waju84/Avarma-R290-Steuerung/docs/bilder/02_verlauf.png

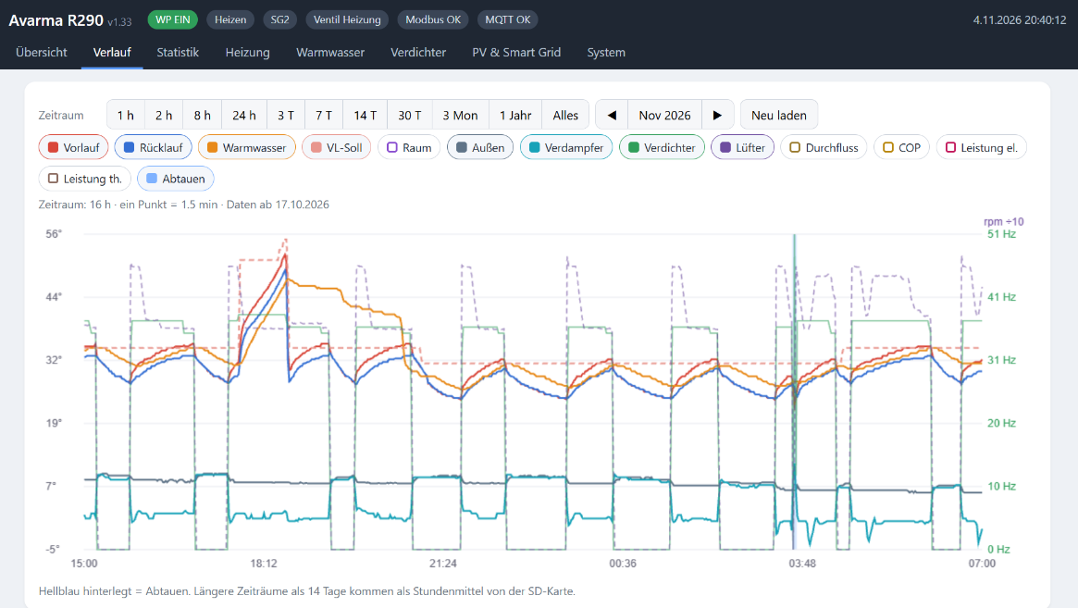
docs/bilder/02_verlauf.png
