waju84/Avarma-R290-Steuerung/docs/bilder/03_statistik.png

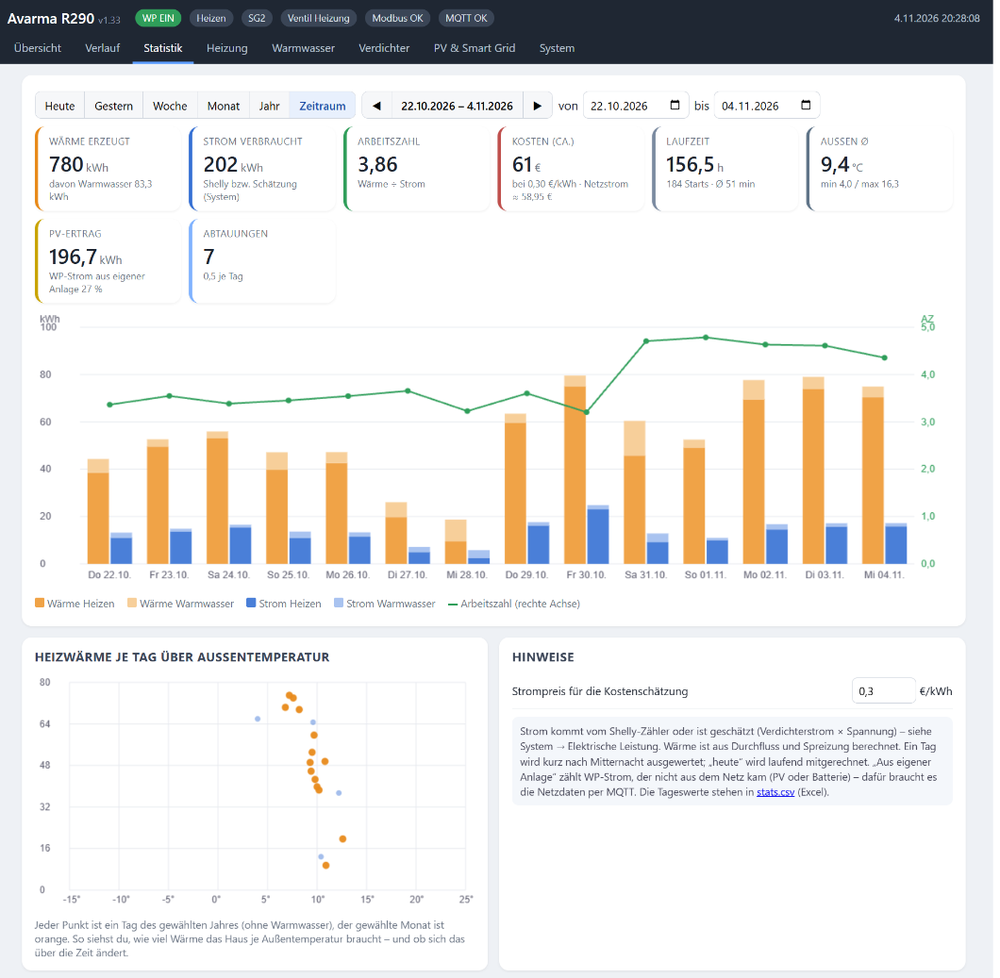
docs/bilder/03_statistik.png
