waju84/Avarma-R290-Steuerung/docs/bilder/04_heizung.png

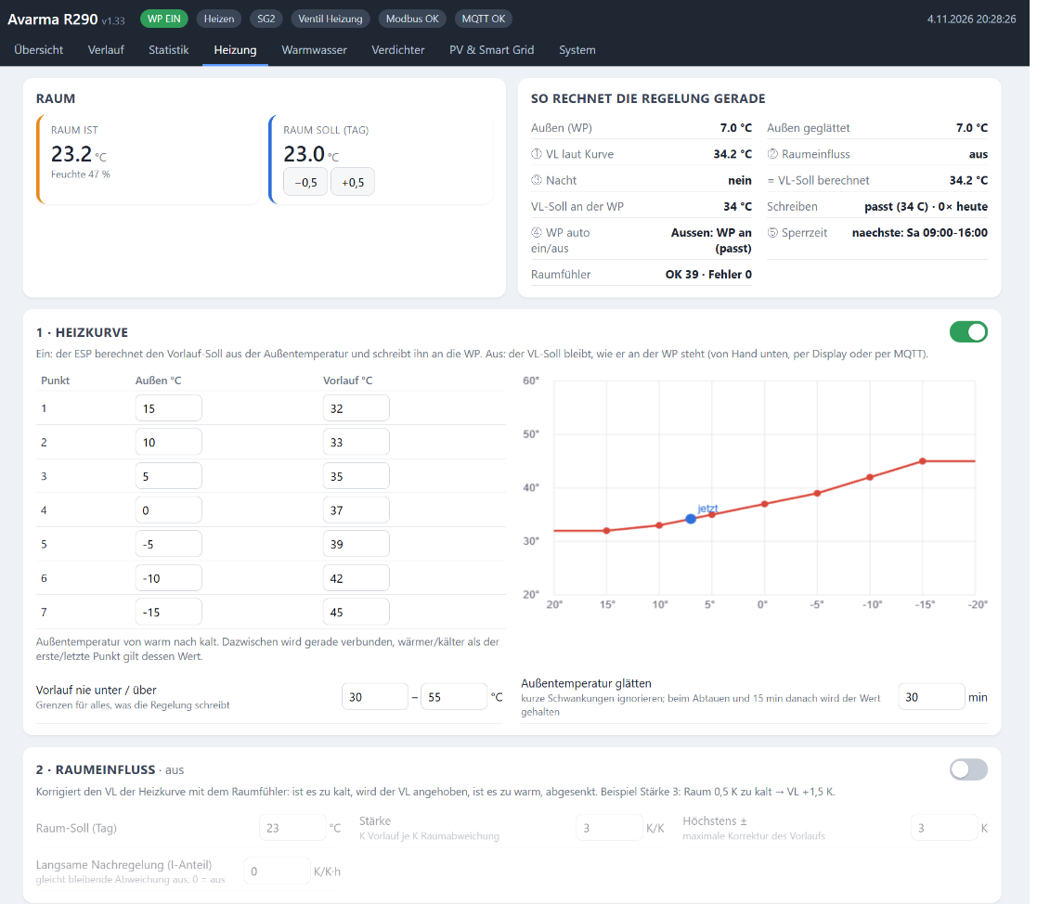
docs/bilder/04_heizung.png
