waju84/Avarma-R290-Steuerung/docs/bilder/05_heizung_automatik.png

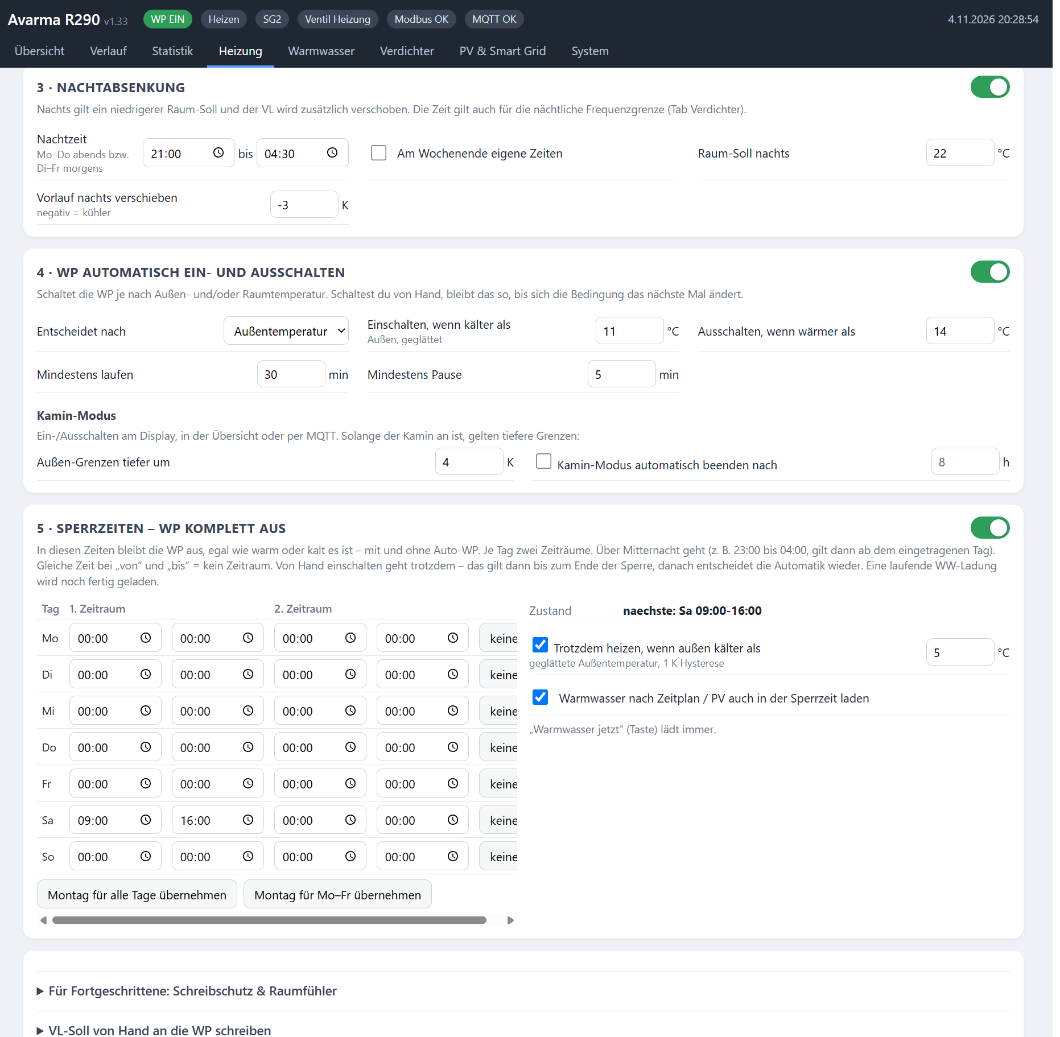
docs/bilder/05_heizung_automatik.png
