waju84/Avarma-R290-Steuerung/docs/bilder/06_warmwasser.png

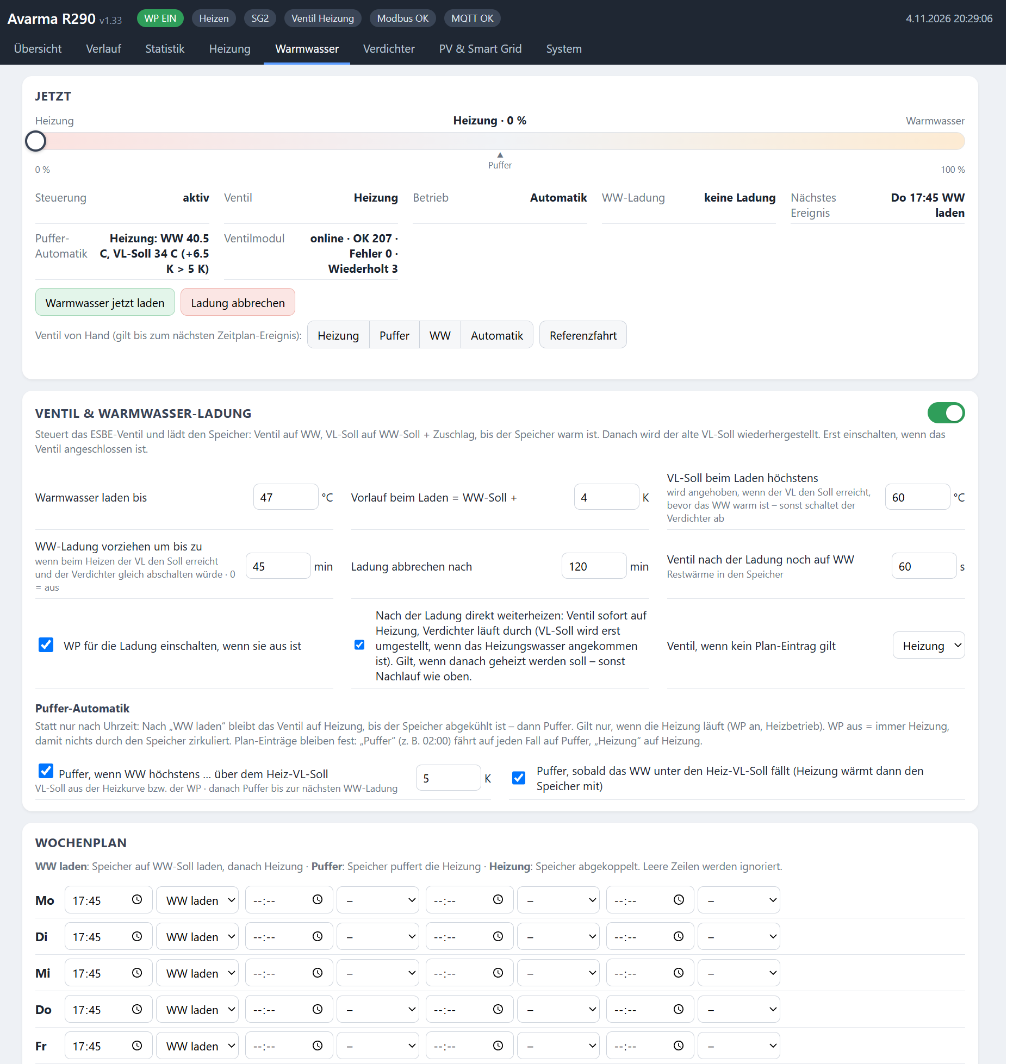
docs/bilder/06_warmwasser.png
