waju84/Avarma-R290-Steuerung/docs/bilder/07_verdichter.png

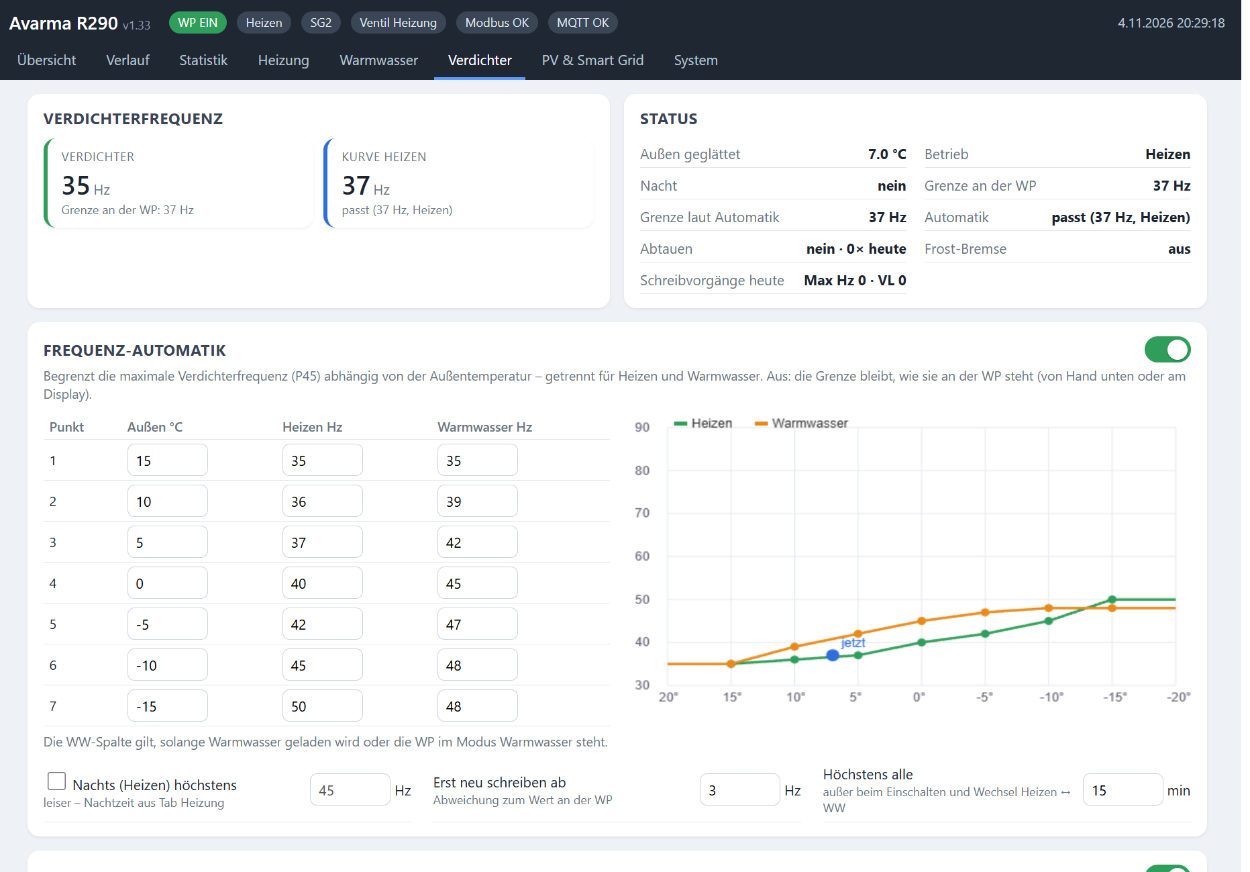
docs/bilder/07_verdichter.png
