waju84/Avarma-R290-Steuerung/docs/bilder/08_abtauen_frostbremse.png

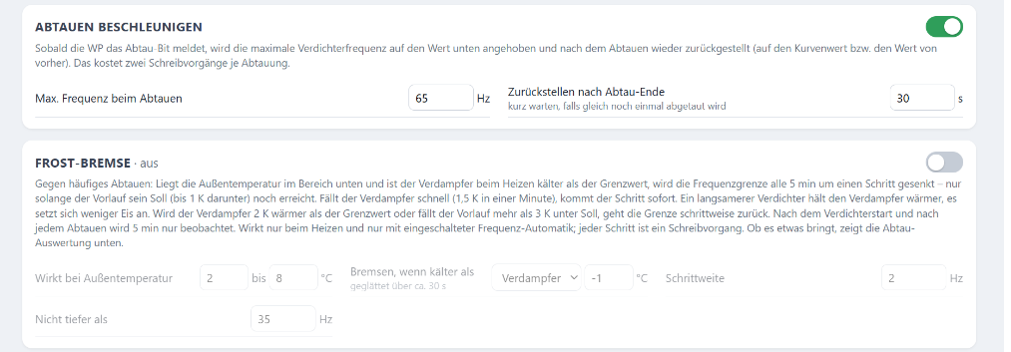
docs/bilder/08_abtauen_frostbremse.png
