waju84/Avarma-R290-Steuerung/docs/bilder/09_pv_smartgrid.png

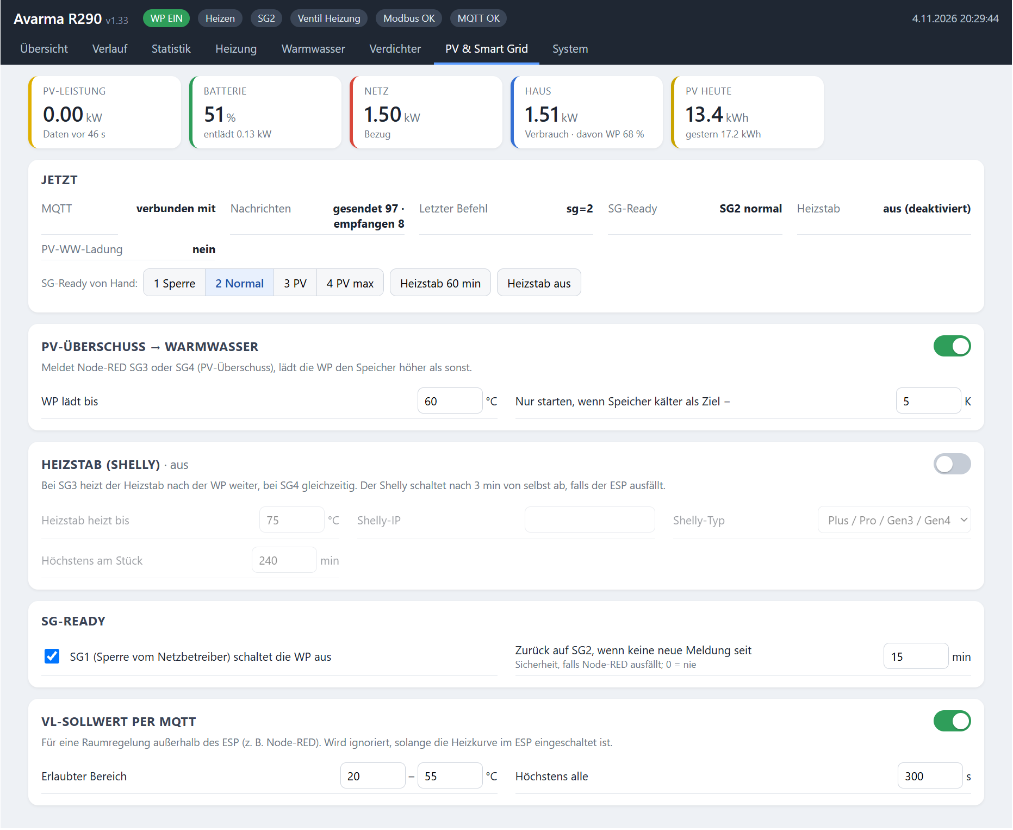
docs/bilder/09_pv_smartgrid.png
