waju84/Avarma-R290-Steuerung/docs/bilder/10_system_nas.png

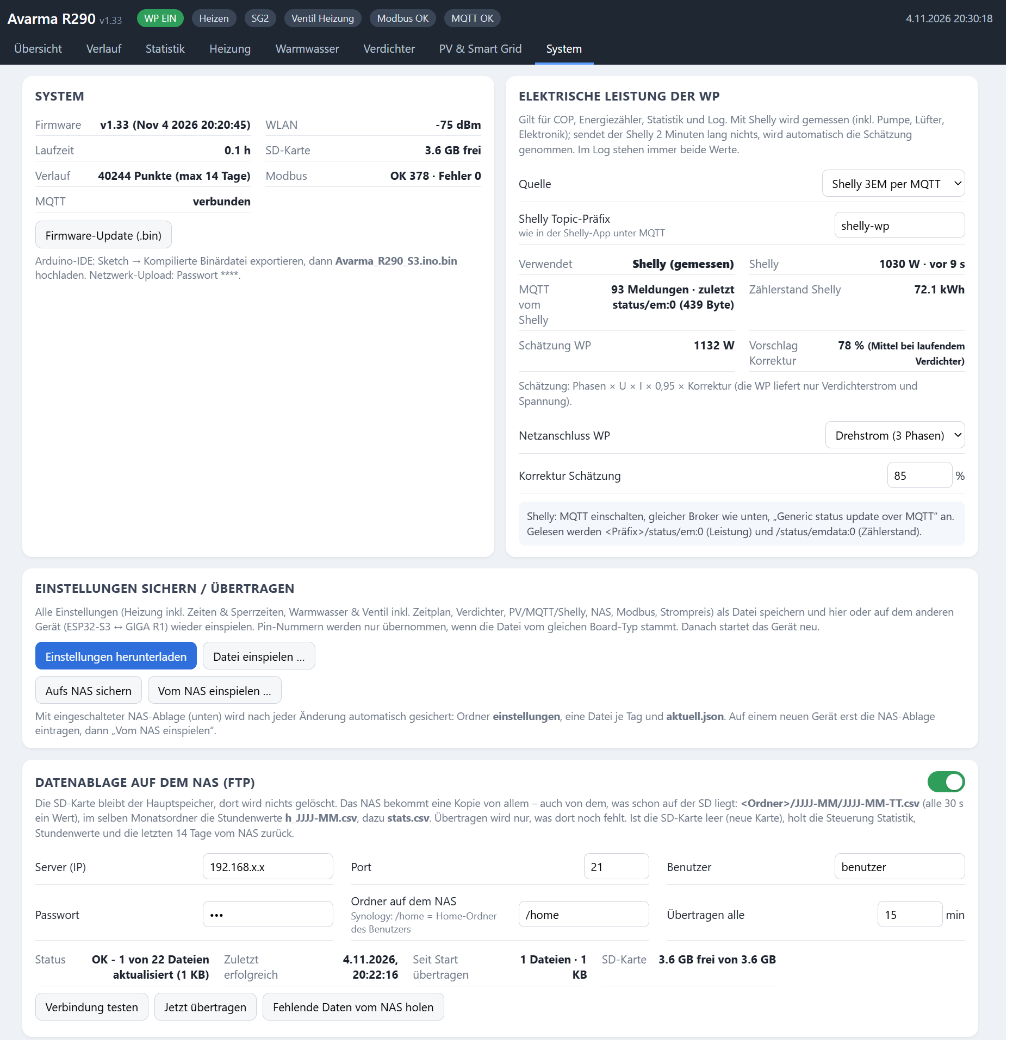
docs/bilder/10_system_nas.png
