waju84/Avarma-R290-Steuerung/Avarma_R290_GIGA/Avarma_R290_GIGA.ino

/*
  =====================================================================
  Avarma R290 Steuerung  –  Arduino GIGA R1 WiFi + GIGA Display Shield
  =====================================================================
  Plattform-Teile: giga_compat.h, giga_ui.h, giga_fonts.h - siehe LIESMICH_GIGA.txt

  Hardware:
    - Arduino GIGA R1 WiFi + GIGA Display Shield (800x480, Touch)
    - RS485-Modul 3,3 V (MAX3485 / SP3485) an Serial1 (D0/D1, DE+RE an D2)

  Arduino IDE: Board "Arduino GIGA R1 WiFi" (Paket "Arduino Mbed OS GIGA Boards")

  Bibliotheken: siehe LIESMICH_GIGA.txt

  Architektur (wichtigste Aenderung gegenueber der alten Version):
    - Modbus laeuft in einem eigenen FreeRTOS-Task. Ein langsamer
      Webrequest oder ein Display-Refresh blockiert die Abfrage nicht mehr.
    - Display + Touch laufen in einem eigenen Task.
    - Web, Logging, SD und Serial laufen in loop().
    - Logging: ein einziger Ringpuffer im PSRAM (14 Tage @ 30 s),
      jeder Punkt mit echtem Zeitstempel. Wird zusaetzlich als
      Tages-CSV auf die SD geschrieben und beim Start von dort
      wieder eingelesen (Verlauf ueberlebt Neustarts).
    - /history liefert serverseitig verdichtete Daten (max. 720 Punkte,
      kompaktes JSON, in 2-kB-Bloecken gesendet) statt tausender
      einzelner client.print()-Aufrufe.
*/

// Arduino GIGA R1 WiFi + GIGA Display Shield: dieselbe Datei, Plattform-Teile in den
// Tabs giga_compat.h (WLAN, Web, Speicher, MQTT, Tasks) und giga_ui.h (800x480-Display)
#include "giga_compat.h"
#include <ModbusMaster.h>

// Standard-Pins je Board (koennen im Web geaendert werden)
#define DEF_SENS_PIN    3     // DHT22 an D3 (SHT4x: I2C an D20/D21)
#define DEF_RELAY_PWR   4     // Ventil-Relais Motorstrom an D4
#define DEF_RELAY_DIR   5     // Ventil-Relais Richtung an D5

// =====================================================
// Datentypen (bewusst ganz oben: die Arduino-IDE setzt ihre
// automatischen Funktions-Prototypen vor die erste Funktion)
// =====================================================
struct LiveData {
  float vorlauf = 0, ruecklauf = 0, warmwasser = 0;
  float flowLmin = 0; uint16_t flowRaw = 0; bool flowValid = false;
  uint16_t verdichterHz = 0;
  float sollwert = 0;
  uint16_t fan1Rpm = 0, fan2Rpm = 0; bool fanRpmValid = false;
  uint16_t maxVerdichterHz = 0; bool maxHzValid = false;
  uint16_t maxFanRpm = 0, maxFanRaw = 0; bool maxFanValid = false;
  uint16_t wpOnOffRaw = 0, wpModeRaw = 0;
  bool wpStateValid = false, wpModeValid = false;
  bool tempsValid = false, hzValid = false, sollValid = false;
  uint32_t errCount = 0, okCount = 0;
  uint8_t  lastErr = 0;          // letzter Modbus-Fehlercode
  uint32_t lastErrMs = 0;

  // erweiterte Werte (Blocklesen 4354..4386 und 4608..4612)
  bool  extValid = false, cntValid = false;
  float ta = 0, coil = 0, discharge = 0, suction = 0, eviIn = 0, eviOut = 0, liquid = 0;
  float evap = 0, cond = 0, ipm = 0, t6 = 0, room = 0, dT = 0;
  float hp = 0, lp = 0, currentA = 0, acV = 0, dcV = 0;
  uint16_t targetHz = 0, state = 0, outputs = 0, inputs = 0;
  uint16_t starts = 0, runtimeH = 0, pumpPct = 0, opMode = 0;
  float pEl = 0, pTh = 0;           // W: elektrisch (Quelle siehe pElSrc), thermisch (berechnet)
  float pElWp = 0;                  // W: Schaetzung aus Verdichterstrom x Spannung (wird immer berechnet)
  float pElSh = NAN;                // W: Messung Shelly (NAN = keine aktuellen Daten)
  uint8_t pElSrc = 0;               // Quelle von pEl: 0 = Schaetzung, 1 = Shelly
  double eElDay = 0, eThDay = 0;    // Wh heute
  double eElYest = 0, eThYest = 0;  // Wh gestern
  double eElTot = 0, eThTot = 0;    // Wh gesamt seit Zaehlerstart
};

// PV-Wert per MQTT (Wert + Empfangszeit)
struct PvVal { volatile float v = NAN; volatile uint32_t ms = 0; };

// Shelly 3EM (Pro 3EM, 3EM-63 Gen3 ...) per MQTT: <elTopic>/status/em:0 und /status/emdata:0
uint8_t  elSrc = 0;                    // Quelle el. Leistung: 0 = Schaetzung aus der WP, 1 = Shelly
char     elTopic[40] = "shelly-wp";    // Topic-Praefix des Shelly (wie in der Shelly-App)
volatile float    shP = NAN, shI = NAN, shETot = NAN;   // W / A / kWh (Zaehlerstand Bezug)
volatile uint32_t shMs = 0, shEMs = 0, shRx = 0;
volatile uint32_t shAny = 0, shBad = 0;   // Diagnose: Meldungen unter <elTopic>/ ueberhaupt / nicht lesbar
volatile int      shLastLen = 0;
char              shLast[48] = "";        // zuletzt empfangenes Shelly-Topic (ohne Praefix)
const uint32_t SH_MAX_AGE = 120000UL;  // so lange ohne Meldung gilt der Shelly-Wert noch
double   shCmpSh = 0, shCmpWp = 0;     // Summen fuer den Korrektur-Vorschlag (bei laufendem Verdichter)

// Raumfuehler (Definition im Heizregelungs-Teil)
extern volatile float rtIst;
bool rtValid();

// Voreinstellungen fuer ein neues Geraet (gespeicherte Einstellungen gehen immer vor)
#ifndef AV_DEF_PV
#define AV_DEF_PV      0     // 1 = PV/Energiemanagement-Teil (z. B. Victron ueber Node-RED) genutzt und eingeblendet
#endif
#ifndef AV_DEF_WWMODE
#define AV_DEF_WWMODE  1     // Warmwasser: 0 = Umschaltventil vom ESP (ESBE), 1 = WW-Modus der WP
#endif

// MQTT-Verbindung (Venus OS)
struct MqttCfg {
  uint8_t  version  = 1;
  uint8_t  enabled  = 1;
  char     host[40] = "";
  uint16_t port     = 1883;
  char     user[32] = "";
  char     pass[48] = "";
  char     base[24] = "avarma";
  uint16_t interval = 10;        // s zwischen zwei Status-Meldungen
};

// Heizregelung (Heizkurve, Raumfuehler, Auto-WP)
#define HC_POINTS 7
struct HcCfg {
  uint8_t  version      = 1;
  uint8_t  enabled      = 0;     // VL-Soll aus Heizkurve schreiben
  int8_t   sensPin      = DEF_SENS_PIN;   // Raumfuehler-Pin (DHT)
  uint8_t  sensType     = 22;    // 22 = DHT22/AM2302, 11 = DHT11, 40 = SHT4x (I2C, nur GIGA)
  int8_t   sensOffset10 = 0;     // Korrektur Raumfuehler in 0,1 K
  int8_t   curveTa[HC_POINTS] = {15, 10, 5, 0, -5, -10, -15};
  uint8_t  curveVl[HC_POINTS] = {28, 32, 37, 40, 45, 50, 52};
  uint16_t rtDay10      = 210;   // Raum-Soll Tag in 0,1 C
  uint16_t rtNight10    = 190;   // Raum-Soll Nacht
  uint8_t  nightOn      = 1;
  uint16_t nightStart   = 22 * 60;
  uint16_t nightEnd     = 6 * 60;
  int8_t   nightVlShift = -3;    // K VL-Verschiebung nachts (zusaetzlich zum Raumeinfluss)
  uint8_t  roomK10      = 30;    // Raumeinfluss: K VL je K Raumabweichung (x10)
  uint8_t  roomKi10     = 0;     // I-Anteil: K VL je K*h (x10), 0 = aus
  uint8_t  roomMax      = 6;     // Raumeinfluss max. +- K
  uint8_t  vlMin        = 25;
  uint8_t  vlMax        = 55;
  uint16_t writeSec     = 600;   // VL hoechstens alle x s schreiben
  uint8_t  taTau        = 30;    // Daempfung Aussentemperatur in min
  uint8_t  autoEnable   = 0;     // WP automatisch EIN/AUS
  uint8_t  autoMode     = 1;     // 1 = Aussen, 2 = Raum, 3 = Aussen + Raum
  int8_t   taOn         = 15;    // WP an unter ... C (gedaempft)
  int8_t   taOff        = 17;    // WP aus ueber ... C
  uint8_t  rtOnBelow10  = 5;     // WP an, wenn Raum < Soll - x (0,1 K)
  uint8_t  rtOffAbove10 = 10;    // WP aus, wenn Raum > Soll + x (0,1 K)
  uint16_t minOnMin     = 30;    // Mindestlaufzeit
  uint16_t minOffMin    = 15;    // Mindestpause
  uint8_t  deadband10   = 15;    // VL erst ab 1,5 K Abweichung neu schreiben (x10)
  // Kamin-Modus: Auto-WP-Grenzen nach unten verschieben
  uint8_t  kaminTa      = 3;     // K: Aussen-Grenzen (an/aus) um x K tiefer
  uint8_t  kaminRt10    = 5;     // 0,1 K: Raum-Soll fuer Auto-WP um x tiefer
  uint8_t  kaminMaxH    = 8;     // Kamin-Modus nach x h automatisch aus (0 = nie)
  uint8_t  roomOn       = 1;     // Raumeinfluss auf den VL ein/aus
  // Wochenende: eigene Nachtzeiten (Beginn Fr + Sa abends, Ende Sa + So morgens)
  uint16_t nightWeStart = 23 * 60;
  uint16_t nightWeEnd   = 8 * 60;
  uint8_t  nightWeOn    = 0;
  uint8_t  rsvNight     = 0;     // frueheres Fuellbyte (alte Einstellungen) - unbenutzt
  // Nachtabsenkung nach Aussentemperatur: eigene Kurve fuer die VL-Verschiebung
  uint8_t  nCurveOn     = 0;     // 0 = feste Verschiebung nightVlShift, 1 = Kurve
  int8_t   nTa[HC_POINTS] = {15, 10, 5, 0, -5, -10, -15};
  int8_t   nDv[HC_POINTS] = {-5, -4, -3, -3, -2, -1, 0};   // K
  // nachts WP ganz aus, wenn es aussen warm genug ist
  uint8_t  nOffOn       = 0;
  int8_t   nOffTa       = 10;    // C (gedaempfte Aussentemperatur, 1 K Hysterese)
};

// Sperrzeiten: WP zu festen Zeiten je Wochentag komplett aus
struct LockCfg {
  uint8_t  version  = 1;
  uint8_t  enabled  = 0;
  uint16_t from[7]  = {1380, 1380, 1380, 1380, 1380, 1380, 1380};   // Minute des Tages, [0] = Montag
  uint16_t to[7]    = {240, 240, 240, 240, 240, 240, 240};         // gleich wie from = an dem Tag keine Sperre
  uint8_t  coldOn   = 1;       // Sperre aufheben, wenn es aussen kaelter ist als ...
  int8_t   coldTa   = 2;       // ... dieser Wert (gedaempfte Aussentemperatur, 1 K Hysterese)
  uint8_t  wwAllow  = 0;       // WW-Ladung nach Zeitplan / PV in der Sperrzeit erlauben
  uint16_t from2[7] = {0, 0, 0, 0, 0, 0, 0};   // zweiter Zeitraum je Tag (gleich = keiner)
  uint16_t to2[7]   = {0, 0, 0, 0, 0, 0, 0};
};

// NAS-Archiv per FTP (Einstellungen, siehe "NAS-Archiv per FTP" weiter unten)
struct FtpCfg {
  uint8_t  version = 1;
  uint8_t  enabled = 0;
  char     host[40] = "";
  uint16_t port = 21;
  char     user[32] = "";
  char     pass[48] = "";
  char     dir[48]  = "/home";
  uint16_t intervalMin = 15;     // alle x Minuten uebertragen
  uint8_t  keepDays = 10;        // so viele Tage bleiben intern fein aufgeloest
};
class FtpClient;
extern volatile bool storageReady;
extern FtpCfg ftpCfg;
extern char ftpMsg[96];
extern volatile uint32_t ftpLastOk;
extern volatile bool ftpBusy;

// Verdichter-Frequenzkurve (Max Hz = P45 aussentemperaturgefuehrt)
struct FcCfg {
  uint8_t  version      = 1;
  uint8_t  enabled      = 0;
  int8_t   ta[HC_POINTS]     = {15, 10, 5, 0, -5, -10, -15};
  uint8_t  hzHeat[HC_POINTS] = {35, 40, 45, 50, 60, 70, 80};
  uint8_t  hzWw[HC_POINTS]   = {50, 55, 60, 65, 70, 75, 80};
  uint8_t  deadband     = 3;     // erst ab dieser Abweichung (Hz) schreiben
  uint16_t minIntMin    = 15;    // hoechstens alle x min schreiben (ausser Wechsel Heizen/WW)
  uint8_t  nightCap     = 0;     // nachts hoechstens x Hz (0 = aus), nur Heizen
  // Abtau-Boost: waehrend des Abtauens Max Hz anheben, danach zuruecksetzen
  uint8_t  dfOn         = 0;
  uint8_t  dfHz         = 70;    // Max Hz waehrend des Abtauens
  uint16_t dfBackSec    = 60;    // so lange nach Abtau-Ende warten, dann zuruecksetzen
  // Sanft ausschalten: vor dem AUS Max Hz absenken
  uint8_t  offLower     = 0;
  uint8_t  offHz        = 35;
  // Frost-Bremse: im Vereisungsbereich die Frequenz senken, solange der Verdampfer kalt ist
  uint8_t  fbOn         = 0;
  int8_t   fbTaLo       = 2;     // wirkt bei Aussentemperatur von ... (C)
  int8_t   fbTaHi       = 8;     // ... bis (C)
  int8_t   fbEvap       = 0;     // bremsen, wenn Verdampfer/Coil kaelter (C)
  uint8_t  fbStep       = 5;     // Hz je Schritt
  uint8_t  fbMinHz      = 35;    // nicht tiefer als
  uint8_t  fbSrc        = 0;     // 0 = Verdampfer (4385), 1 = Coil (4358)
};

// SG-Ready / PV / Heizstab / VL per MQTT
struct PvCfg {
  uint8_t  version      = 1;
  uint8_t  pvWwEnable   = 1;     // SG3/4 -> WW-Ladung per WP
  uint8_t  pvWwSoll     = 60;    // Ziel WP bei PV-Ladung
  uint8_t  pvWwHyst     = 5;     // PV-Ladung startet erst unter pvWwSoll - Hyst
  uint8_t  heaterEnable = 0;     // Heizstab ueber Shelly
  uint8_t  heaterSoll   = 75;    // Ziel Heizstab
  uint8_t  heaterGen    = 2;     // Shelly Generation: 1 oder 2 (Plus/Pro/Gen3/Gen4)
  char     shellyIp[40] = "";
  uint16_t heaterMaxMin = 240;   // max. Heizstab-Laufzeit am Stueck
  uint16_t sgTimeoutMin = 15;    // ohne Auffrischung zurueck auf SG2
  uint8_t  sg1Block     = 1;     // SG1 schaltet WP aus
  uint8_t  vlMqtt       = 1;     // VL-Sollwert per MQTT erlaubt
  uint8_t  vlMin        = 20;
  uint8_t  vlMax        = 55;
  uint16_t vlMinSec     = 300;   // min. Abstand zwischen zwei VL-Schreibvorgaengen
  uint8_t  show         = AV_DEF_PV;   // PV/Energiemanagement nutzen und im Web anzeigen
};

enum : uint8_t {
  F_TEMPS = 0x01, F_WPON = 0x02, F_FLOW = 0x04, F_FAN = 0x08,
  F_HZ = 0x10, F_SV = 0x20, F_WPVALID = 0x40, F_MODEVALID = 0x80
};

enum : uint8_t { F2_EXT = 0x01, F2_DEFROST = 0x02, F2_WWLOAD = 0x04 };

struct LogPoint {              // 40 Byte
  uint32_t t;                  // UTC epoch
  int16_t  vl, rl, ww;         // 1/10 C
  int16_t  flow;               // 1/10 L/min
  uint16_t fan1, fan2;         // rpm
  uint8_t  hz, sv, mode, flags;
  int16_t  rt;                 // Raum 1/10 C, INT16_MIN = ungueltig
  int16_t  ta, evap;           // Aussen / Verdampfer 1/10 C, INT16_MIN = ungueltig
  int16_t  pEl, pTh;           // W elektrisch (verwendete Quelle) / thermisch
  int16_t  grid;               // W Netz (+ Bezug), INT16_MIN = ungueltig
  uint16_t pv;                 // W PV, 0xFFFF = ungueltig
  uint8_t  f2, rsv;            // F2_...
  int16_t  pElWp, pElSh;       // W Schaetzung WP / Messung Shelly, INT16_MIN = ungueltig
};

struct HistOut { uint32_t t; float vl, rl, ww, hz, flow, rt, ta, evap, sv, cop, dfr, pel, pth, wwf, fan; bool gap; };

// Summen fuer Mittelwerte (Verlauf, Stundenmittel)
struct HistAcc {
  double sT, sVl, sRl, sWw, sHz, sFl, sRt, sTa, sEv, sSv, sEl, sTh, sPv, sFan;
  uint32_t n, nFl, nRt, nTa, nSv, nPw, nDf, nPv, nWw, nFan;
};

// Tageswerte fuer die Statistik
struct DayStat {
  int32_t  day;                // JJJJMMTT
  double   el, th, elWw, thWw, pv, elG, elOwn;   // Wh
  double   runSec, taSum, rtSum;
  float    taMin, taMax;
  uint32_t n, nExt, nPv, taN, rtN, lastT;
  uint16_t starts, defrosts;
  bool     lastRun, lastDf;
};

// Hilfsstruktur beim Verdichten des Verlaufs
struct HistBuild {
  uint32_t fromT, bucket, gapLimit;
  int maxPts, n;
  int64_t curB;
  HistAcc acc;
  HistOut* out;
};

enum CmdType : uint8_t {
  CMD_SET_SOLL, CMD_POWER, CMD_MODE, CMD_MAXHZ, CMD_MAXFAN,
  CMD_READ_SOLL, CMD_READ_ALL, CMD_READ_MAXHZ, CMD_READ_MAXFAN,
  CMD_READ_FAN, CMD_READ_FLOW,
  CMD_READ_PARAMS, CMD_SET_P06, CMD_SET_P07, CMD_READ_RAW
};

struct MbCmd {
  CmdType type;
  float value;
  bool wait;    // loop() wartet auf das Ergebnis
  bool print;   // Ausgabe auf Serial (Befehl kam von Serial)
};

enum Page : uint8_t { PAGE_STATUS = 0, PAGE_CHART, PAGE_CTRL, PAGE_WP, PAGE_PV, PAGE_EXPERT };

enum BtnId : int {
  B_NONE = -1,
  B_TAB0 = 1, B_TAB1, B_TAB2, B_TAB3,
  B_RT_M, B_RT_P, B_HC_TOG, B_AUTO_TOG,
  B_H1, B_H2, B_H8, B_H24,
  B_SOLL_M, B_SOLL_P, B_SOLL_SET,
  B_HZ_M, B_HZ_P, B_HZ_SET,
  B_FAN_M, B_FAN_P, B_FAN_SET,
  B_ON, B_OFF, B_HEIZ, B_WW, B_KUEHL,
  B_WWLOAD,
  B_TAB4, B_KAMIN, B_FC_TOG, B_EXPERT, B_BACK, B_ROOM_TOG
};

struct Btn { int16_t x, y, w, h; int id; };

// ---- ESBE-Ventil / Warmwasser ----
#define SCHED_SLOTS      4
#define CTRL_CFG_VERSION 1
enum : uint8_t { ACT_NONE = 0, ACT_WW = 1, ACT_PUFFER = 2, ACT_HEIZ = 3 };
enum : uint8_t { WW_IDLE = 0, WW_MOVE, WW_HEAT, WW_COOL, WW_BACK };   // WW_BACK: Ventil zurueck auf Heizung, Verdichter laeuft weiter

struct SchedEv { uint16_t min; uint8_t act; };   // min = Minute des Tages

struct CtrlCfg {
  uint8_t  version   = CTRL_CFG_VERSION;
  bool     enabled   = false;  // erst im Web aktivieren, wenn verdrahtet
  int8_t   pinPwr    = DEF_RELAY_PWR;   // Relais 1: Motor-Versorgung
  int8_t   pinDir    = DEF_RELAY_DIR;   // Relais 2: Richtung (aus = Heizung, an = WW)
  bool     actLow    = false;  // Relaismodul schaltet bei LOW
  bool     dirInv    = false;  // Richtung vertauscht
  uint16_t travelSec = 130;    // Laufzeit Endlage -> Endlage
  uint8_t  bufPos    = 50;     // Puffer-Stellung in %
  uint8_t  defAct    = ACT_HEIZ; // Stellung, wenn kein Zeitplan-Ereignis existiert
  uint8_t  wwSoll    = 50;     // Ziel-Temperatur WW-Speicher
  uint8_t  boost     = 4;      // VL-Soll beim Laden = WW-Soll + boost
  uint16_t maxMin    = 120;    // max. Ladedauer
  uint16_t coolSec   = 60;     // Ventil nach Ladung noch so lange auf WW
  bool     wpOnForWw = true;   // WP fuer WW-Ladung einschalten, falls aus
  SchedEv  sched[7][SCHED_SLOTS];   // [0] = Montag
  // --- ab hier neu (aeltere gespeicherte Konfigurationen werden ergaenzt) ---
  uint8_t  drive     = 0;      // 0 = Relais am ESP, 1 = Ventilmodul am Modbus (Arduino)
  uint8_t  slaveId   = 2;      // Modbus-ID des Ventilmoduls
  uint8_t  fsMin     = 10;     // Modul faehrt nach x min ohne ESP auf Heizung (0 = aus)
  uint8_t  wwNoCont  = 0;      // 0 = nach der Ladung direkt weiterheizen (Verdichter laeuft durch), 1 = Nachlauf wie frueher
                               //     (liegt im frueheren Fuellbyte -> alte Einstellungen lesen hier 0)
  uint8_t  wwPullMin = 30;     // WW-Zeitplan bis zu x min vorziehen, wenn der Verdichter beim Heizen gerade abschalten wuerde (0 = aus)
  uint8_t  wwVlMax   = 60;     // VL-Soll beim Laden wird bei Bedarf bis hierhin angehoben (sonst stoppt der Verdichter am VL-Soll)
  // Puffer-Automatik: nach der WW-Ladung erst auf Puffer, wenn der Speicher abgekuehlt ist
  uint8_t  abOn      = 0;      // Puffer, wenn WW <= Heiz-VL-Soll + abK
  int8_t   abK       = 3;      // K
  uint8_t  abLow     = 0;      // Puffer, wenn WW < Heiz-VL-Soll
  uint8_t  abFixOn   = 0;      // Puffer, wenn WW <= abFixT (feste Temperatur, unabhaengig vom VL-Soll)
  uint8_t  abFixT    = 35;     // C
  uint8_t  wwMode    = AV_DEF_WWMODE;   // 0 = Umschaltventil vom ESP (ESBE), 1 = WW-Modus der WP (WP schaltet ihr Ventil selbst)
};

// =====================================================
// WLAN / Zeit
// =====================================================
// Firmware-Version: bei jeder Aenderung hochzaehlen (steht im Web, auf dem Display und in der Konsole)
#define FW_VERSION "1.36"
#define AV_PLATFORM "GIGA R1"
#define SD_NAME     "Speicher"
static const char FW_BUILD[] = __DATE__ " " __TIME__;       // Zeitpunkt des Kompilierens

// ============================================================
// >>> HIER DEINE WLAN-ZUGANGSDATEN EINTRAGEN <<<
// (Name und Passwort deines WLANs, 2,4 GHz)
// ============================================================
static const char* WIFI_SSID = "DEIN_WLAN_NAME";
static const char* WIFI_PASS = "DEIN_WLAN_PASSWORT";
static const char* HOSTNAME  = "avarma";                       // -> http://avarma.local
static const char* OTA_PASSWORD = "bitte-aendern";                      // Passwort fuer Upload per Netzwerk (Arduino-IDE)
static const char* TZ_INFO   = "CET-1CEST,M3.5.0,M10.5.0/3";   // Europa/Berlin
static const char* NTP1      = "pool.ntp.org";
static const char* NTP2      = "ptbtime1.ptb.de";

// =====================================================
// MODBUS PINS  (freie GPIOs am Erweiterungsstecker: IO2 / IO3 / IO14 / IO21)
//   ACHTUNG: ESP32-S3 ist NICHT 5V-tolerant. MAX485-Modul mit 3,3 V
//   versorgen oder einen MAX3485 / Pegelwandler verwenden.
// =====================================================
// GIGA: RS485-Modul (3,3 V!) an Serial1: RO -> D0 (RX0), DI -> D1 (TX0), DE+/RE -> D2
#define MB_RX_PIN       0
#define MB_TX_PIN       1
#define MAX485_DE_RE    2
#define MB_BAUD      9600
#define MB_SLAVE_ID     1


// =====================================================
// Einstellgrenzen
// =====================================================
static const uint16_t MAX_HZ_MIN  = 30;
static const uint16_t MAX_HZ_MAX  = 85;
static const uint16_t FAN_RPM_MIN = 300;
static const uint16_t FAN_RPM_MAX = 600;
static const int      SOLL_MIN    = 10;
static const int      SOLL_MAX    = 75;

// =====================================================
// Modbus Register
// =====================================================
static const uint16_t REG_ONOFF = 4096;
static const uint16_t REG_MODE  = 4097;
static const uint16_t REG_SOLL  = 4098;

static const uint16_t REG_RL   = 4365;
static const uint16_t REG_VL   = 4366;
static const uint16_t REG_WW   = 4367;
static const uint16_t REG_FLOW = 4368;  // raw / 10 = L/min

static const uint16_t REG_HZ       = 4373;
static const uint16_t REG_FAN1_RPM = 4374;
static const uint16_t REG_FAN2_RPM = 4375;

static const uint16_t REG_MAX_HZ      = 8235;  // P45 Max Verdichterfrequenz, 1 Hz
static const uint16_t REG_MAX_FAN_RPM = 8250;  // P60 Max Luefter, raw = rpm / 10

// =====================================================
// Abfrageintervalle
// =====================================================
const uint32_t TEMPS_INTERVAL_MS   = 3000;
const uint32_t FLOW_INTERVAL_MS    = 5000;
const uint32_t HZ_INTERVAL_MS      = 5000;
const uint32_t FANRPM_INTERVAL_MS  = 5000;
const uint32_t SOLL_INTERVAL_MS    = 7000;
const uint32_t MAXHZ_INTERVAL_MS   = 15000;
const uint32_t MAXFAN_INTERVAL_MS  = 15000;
const uint32_t WPSTATE_INTERVAL_MS = 10000;
const uint32_t WIFI_RETRY_MS       = 30000;

// =====================================================
// Logging
// =====================================================
const uint32_t LOG_INTERVAL_SEC   = 30;                 // Aufloesung
const uint32_t LOG_DAYS_PSRAM     = 14;                 // RAM-Verlauf mit PSRAM
const uint32_t LOG_DAYS_NOPSRAM   = 1;                  // Fallback ohne PSRAM
const uint32_t SD_FLUSH_MS        = 5UL * 60UL * 1000UL; // alle 5 min auf SD schreiben
const uint32_t SD_RETRY_MS        = 60UL * 1000UL;
const int      HIST_WEB_MAX       = 720;                // max. Punkte pro /history-Antwort
const int      HIST_DISP_MAX      = 256;                // max. Punkte fuer Display-Chart


// =====================================================
// Globale Objekte
// =====================================================
ModbusMaster node;
WebServer server(80);

// =====================================================
// Live-Werte (geschrieben vom Modbus-Task, gelesen von allen)
// =====================================================

// =====================================================
// Log: geht auf USB-Serial UND in einen Ringpuffer fuer die Web-Konsole
// =====================================================
static char logRing[16384];
static volatile uint32_t logRingTotal = 0;
static portMUX_TYPE logMux = portMUX_INITIALIZER_UNLOCKED;

class TeeLog : public Print {
  volatile bool lineStart = true;
  void put(const char* p, size_t n) {
    if (!n) return;
    if (Serial) Serial.write((const uint8_t*)p, n);
    portENTER_CRITICAL(&logMux);
    for (size_t i = 0; i < n; i++) { logRing[logRingTotal % sizeof(logRing)] = p[i]; logRingTotal++; }
    portEXIT_CRITICAL(&logMux);
  }
  void stamp() {                       // Zeitstempel an jedem Zeilenanfang
    char p[24];
    time_t t = time(nullptr);
    if (t > 1700000000) { struct tm tmv; localtime_r(&t, &tmv);
      snprintf(p, sizeof(p), "%02d:%02d:%02d ", tmv.tm_hour, tmv.tm_min, tmv.tm_sec); }
    else snprintf(p, sizeof(p), "[%lus] ", (unsigned long)(millis() / 1000));
    put(p, strlen(p));
  }
public:
  size_t write(uint8_t c) override { return write(&c, 1); }
  size_t write(const uint8_t* b, size_t n) override {
    char tmp[128]; size_t k = 0;
    for (size_t i = 0; i < n; i++) {
      if (lineStart) { put(tmp, k); k = 0; stamp(); lineStart = false; }
      tmp[k++] = (char)b[i];
      if (b[i] == '\n') lineStart = true;
      if (k == sizeof(tmp)) { put(tmp, k); k = 0; }
    }
    put(tmp, k);
    return n;
  }
  using Print::write;
  size_t printf(const char* fmt, ...) __attribute__((format(printf, 2, 3))) {   // Print hat hier kein printf
    char b[256];
    va_list ap; va_start(ap, fmt);
    int n = vsnprintf(b, sizeof(b), fmt, ap);
    va_end(ap);
    if (n < 0) return 0;
    if (n < (int)sizeof(b)) return write((const uint8_t*)b, n);
    char* big = (char*)malloc(n + 1);
    if (!big) return write((const uint8_t*)b, sizeof(b) - 1);
    va_start(ap, fmt); vsnprintf(big, n + 1, fmt, ap); va_end(ap);
    size_t r = write((const uint8_t*)big, n);
    free(big);
    return r;
  }
};
TeeLog Log;

// =====================================================
// Modbus-Einstellungen (im Flash gespeichert, ueber Weboberflaeche aenderbar)
// =====================================================
struct MbConfig {
  int8_t   rx   = MB_RX_PIN;
  int8_t   tx   = MB_TX_PIN;
  int8_t   de   = MAX485_DE_RE;
  uint8_t  mode = 0;            // 0 = DE per Software, 1 = Hardware-RS485 (UART steuert DE)
  uint32_t baud = MB_BAUD;
  uint8_t  id   = MB_SLAVE_ID;
  uint8_t  gap  = 3;            // ms Wartezeit nach dem Senden, dann Stoerbytes verwerfen
};
MbConfig mbCfg;
Preferences prefs;

void loadMbConfig() {
  prefs.begin("modbus", true);
  mbCfg.rx   = prefs.getChar("rx", MB_RX_PIN);
  mbCfg.tx   = prefs.getChar("tx", MB_TX_PIN);
  mbCfg.de   = prefs.getChar("de", MAX485_DE_RE);
  mbCfg.mode = prefs.getUChar("mode", 0);
  mbCfg.baud = prefs.getULong("baud", MB_BAUD);
  mbCfg.id   = prefs.getUChar("id", MB_SLAVE_ID);
  mbCfg.gap  = prefs.getUChar("gap", 3);
  prefs.end();
}

void saveMbConfig() {
  prefs.begin("modbus", false);
  prefs.putChar("rx", mbCfg.rx);
  prefs.putChar("tx", mbCfg.tx);
  prefs.putChar("de", mbCfg.de);
  prefs.putUChar("mode", mbCfg.mode);
  prefs.putULong("baud", mbCfg.baud);
  prefs.putUChar("id", mbCfg.id);
  prefs.putUChar("gap", mbCfg.gap);
  prefs.end();
}

const char* mbErrText(uint8_t c) {
  switch (c) {
    case 0:    return "-";
    case 1:    return "Exception: Funktion";
    case 2:    return "Exception: Adresse";
    case 3:    return "Exception: Wert";
    case 4:    return "Exception: Geraetefehler";
    case 0xE0: return "falsche Slave-ID";
    case 0xE1: return "falsche Funktion";
    case 0xE2: return "Timeout";
    case 0xE3: return "CRC falsch";
    default:   return "unbekannt";
  }
}

LiveData live;
SemaphoreHandle_t liveMutex;

static inline void liveLock()   { xSemaphoreTake(liveMutex, portMAX_DELAY); }
static inline void liveUnlock() { xSemaphoreGive(liveMutex); }

LiveData getLive() {
  liveLock();
  LiveData c = live;
  liveUnlock();
  return c;
}

// Letzte Befehlsmeldung (fuer Display + Web)
char cmdMsg[64] = "";
uint32_t cmdMsgMs = 0;

void setCmdMsg(const char* fmt, ...) {
  char tmp[64];
  va_list ap; va_start(ap, fmt);
  vsnprintf(tmp, sizeof(tmp), fmt, ap);
  va_end(ap);
  liveLock();
  strlcpy(cmdMsg, tmp, sizeof(cmdMsg));
  cmdMsgMs = millis();
  liveUnlock();
}

uint32_t getCmdMsg(char* out, size_t n) {   // liefert Alter in ms
  liveLock();
  strlcpy(out, cmdMsg, n);
  uint32_t age = cmdMsg[0] ? millis() - cmdMsgMs : 0xFFFFFFFF;
  liveUnlock();
  return age;
}

volatile bool verbose  = false;   // Serial: jede Abfrage ausgeben ("VERBOSE")
volatile bool cmdPrint = false;   // aktueller Befehl kam von Serial -> Ausgabe
volatile bool restartRequested = false;
bool     restartHold = false;            // Einstellungs-Import: Neustart erst am Ende (max. 60 s)
uint32_t restartHoldMs = 0;
volatile bool touchDebug = false; // Serial: Touch-Koordinaten ausgeben ("TOUCH")
bool touchChipFound = false;
int32_t lastTouchX = -1, lastTouchY = -1;
uint32_t lastTouchMs = 0;

#define MBLOG(...) do { if (verbose || cmdPrint) Log.printf(__VA_ARGS__); } while (0)

// =====================================================
// Zeit
// =====================================================
bool timeValid() { return time(nullptr) > 1700000000; }
uint32_t nowUtc() { return timeValid() ? (uint32_t)time(nullptr) : 0; }

const char* modeName(uint16_t mode) {
  if (mode == 1) return "WW";
  if (mode == 2) return "Heizen";
  if (mode == 4) return "Kuehlen";
  if (mode == 0) return "Off";
  return "Unbekannt";
}

// =====================================================
// Logging-Ringpuffer
// =====================================================

LogPoint* logBuf = nullptr;
uint32_t logCap = 0, logHead = 0, logCount = 0;
uint32_t logTotal = 0;              // Anzahl jemals hinzugefuegter Punkte
uint32_t sdFlushedTotal = 0;        // bis hierhin auf SD geschrieben
uint32_t lastLogSlot = 0;
bool historyRestored = false;
volatile bool restoringHistory = false;
SemaphoreHandle_t logMutex;

// weiter unten definiert
extern volatile uint8_t wwState;
extern PvVal pvPower, pvGrid, pvSoc;
float pvGet(const PvVal& p, uint32_t maxAgeMs);
bool sdOk = false;                  // SD-Karte bereit

static inline LogPoint& logAt(uint32_t pos) {       // pos 0 = aeltester Punkt
  return logBuf[(logHead + logCap - logCount + pos) % logCap];
}

void logPush(const LogPoint& p) {
  xSemaphoreTake(logMutex, portMAX_DELAY);
  logBuf[logHead] = p;
  logHead = (logHead + 1) % logCap;
  if (logCount < logCap) logCount++;
  logTotal++;
  xSemaphoreGive(logMutex);
}

uint32_t lastLoggedT() {
  return logCount ? logAt(logCount - 1).t : 0;
}
uint32_t firstLoggedT() {
  return logCount ? logAt(0).t : 0;
}

float logCapacityHours() { return (float)logCap * LOG_INTERVAL_SEC / 3600.0f; }

void allocLogBuffer() {
  if (psramFound()) {
    logCap = LOG_DAYS_PSRAM * 86400UL / LOG_INTERVAL_SEC;
    logBuf = (LogPoint*)ps_malloc(sizeof(LogPoint) * logCap);
  }
  if (!logBuf) {
    logCap = LOG_DAYS_NOPSRAM * 86400UL / LOG_INTERVAL_SEC;
    logBuf = (LogPoint*)malloc(sizeof(LogPoint) * logCap);
  }
  if (!logBuf) { logCap = 0; Log.println("FEHLER: kein Speicher fuer Log!"); return; }
  Log.printf("Log-Puffer: %lu Punkte (%.1f h) in %s\n",
                (unsigned long)logCap, logCapacityHours(), psramFound() ? "PSRAM" : "RAM");
}

void logPointInit(LogPoint& p) {
  memset(&p, 0, sizeof(p));
  p.rt = INT16_MIN; p.ta = INT16_MIN; p.evap = INT16_MIN; p.grid = INT16_MIN; p.pv = 0xFFFF;
  p.pElWp = INT16_MIN; p.pElSh = INT16_MIN;
}

// ---------- Mittelwerte fuer Verlauf (Rohpunkte und Stundenmittel) ----------
void accReset(HistAcc& a) { memset(&a, 0, sizeof(a)); }

void accAddPoint(HistAcc& a, const LogPoint& p) {
  if (!(p.flags & F_TEMPS)) return;
  a.sT += p.t; a.n++;
  a.sVl += p.vl / 10.0; a.sRl += p.rl / 10.0; a.sWw += p.ww / 10.0; a.sHz += p.hz;
  if (p.flags & F_FLOW)  { a.sFl += p.flow / 10.0; a.nFl++; }
  if (p.flags & F_FAN)   { a.sFan += p.fan1; a.nFan++; }
  if (p.rt != INT16_MIN) { a.sRt += p.rt / 10.0; a.nRt++; }
  if (p.ta != INT16_MIN) { a.sTa += p.ta / 10.0; a.sEv += p.evap / 10.0; a.nTa++; }
  if (p.flags & F_SV)    { a.sSv += p.sv; a.nSv++; }
  if (p.f2 & F2_EXT)     { a.sEl += p.pEl; a.sTh += p.pTh; a.nPw++; if (p.f2 & F2_DEFROST) a.nDf++;
                           if ((p.f2 & F2_WWLOAD) || ((p.flags & F_MODEVALID) && p.mode == 1)) a.nWw++; }
  if (p.pv != 0xFFFF)    { a.sPv += p.pv; a.nPv++; }
}

// Stundenzeile aus h_JJJJ-MM.csv: t;n;vl;rl;ww;hz;flow;nFl;rt;nRt;ta;evap;nTa;sv;nSv;pEl;pTh;nPw;nDf;pv;nPv[;nWw[;fan;nFan]]
bool parseHourRow(char* line, uint32_t& t, HistAcc& r) {
  if (line[0] < '0' || line[0] > '9') return false;
  double v[24]; int nf = 0;
  char* s = line;
  while (nf < 24) {
    char* sep = strchr(s, ';');
    if (sep) *sep = 0;
    v[nf++] = *s ? strtod(s, nullptr) : 0;
    if (!sep) break;
    s = sep + 1;
  }
  if (nf < 21) return false;
  accReset(r);
  t = (uint32_t)v[0];
  uint32_t n = (uint32_t)v[1];
  if (!n) return false;
  r.n = n; r.sT = (double)t * n;
  r.sVl = v[2] * n; r.sRl = v[3] * n; r.sWw = v[4] * n; r.sHz = v[5] * n;
  r.nFl = (uint32_t)v[7];  r.sFl = v[6] * r.nFl;
  r.nRt = (uint32_t)v[9];  r.sRt = v[8] * r.nRt;
  r.nTa = (uint32_t)v[12]; r.sTa = v[10] * r.nTa; r.sEv = v[11] * r.nTa;
  r.nSv = (uint32_t)v[14]; r.sSv = v[13] * r.nSv;
  r.nPw = (uint32_t)v[17]; r.sEl = v[15] * r.nPw; r.sTh = v[16] * r.nPw; r.nDf = (uint32_t)v[18];
  r.nPv = (uint32_t)v[20]; r.sPv = v[19] * r.nPv;
  r.nWw = nf > 21 ? (uint32_t)v[21] : 0;              // ab v1.15
  if (nf > 23) { r.nFan = (uint32_t)v[23]; r.sFan = v[22] * r.nFan; }   // ab v1.33
  return true;
}

void accAddAcc(HistAcc& a, const HistAcc& b) {
  a.sT += b.sT; a.n += b.n; a.sVl += b.sVl; a.sRl += b.sRl; a.sWw += b.sWw; a.sHz += b.sHz;
  a.sFl += b.sFl; a.nFl += b.nFl; a.sRt += b.sRt; a.nRt += b.nRt;
  a.sTa += b.sTa; a.sEv += b.sEv; a.nTa += b.nTa; a.sSv += b.sSv; a.nSv += b.nSv;
  a.sEl += b.sEl; a.sTh += b.sTh; a.nPw += b.nPw; a.nDf += b.nDf; a.sPv += b.sPv; a.nPv += b.nPv; a.nWw += b.nWw;
  a.sFan += b.sFan; a.nFan += b.nFan;
}

void accOut(const HistAcc& a, HistOut& o) {
  o.t    = (uint32_t)(a.sT / a.n);
  o.vl   = a.sVl / a.n; o.rl = a.sRl / a.n; o.ww = a.sWw / a.n; o.hz = a.sHz / a.n;
  o.flow = a.nFl ? a.sFl / a.nFl : NAN;
  o.rt   = a.nRt ? a.sRt / a.nRt : NAN;
  o.ta   = a.nTa ? a.sTa / a.nTa : NAN;
  o.evap = a.nTa ? a.sEv / a.nTa : NAN;
  o.sv   = a.nSv ? a.sSv / a.nSv : NAN;
  o.cop  = (a.nPw && a.sEl / a.nPw > 100) ? constrain(a.sTh / a.sEl, 0.0, 10.0) : NAN;
  o.dfr  = a.nPw ? (float)a.nDf / a.nPw : 0;
  o.pel  = a.nPw ? a.sEl / a.nPw : NAN;
  o.pth  = a.nPw ? a.sTh / a.nPw : NAN;
  o.wwf  = a.nPw ? (float)a.nWw / a.nPw : 0;
  o.fan  = a.nFan ? a.sFan / a.nFan : NAN;
  o.gap  = false;
}

// Monatsdatei mit Stundenmitteln
void monthFileName(uint32_t t, char* out, size_t n) {
  time_t tt = t; struct tm tmv; localtime_r(&tt, &tmv);
  snprintf(out, n, "/log/h_%04d-%02d.csv", tmv.tm_year + 1900, tmv.tm_mon + 1);
}

// Stundenmittel von SD lesen (fuer Zeitraeume, die nicht mehr im RAM sind)
void readHourRowsImpl(uint32_t fromT, uint32_t toT, void (*cb)(void*, uint32_t, const HistAcc&), void* ctx) {
  if (!sdOk || toT <= fromT) return;
  static char rbuf[2048];
  char line[200];
  // Monat fuer Monat (Start am 15. des Monats, damit das Weiterzaehlen sicher ist)
  time_t tt = fromT; struct tm tmv; localtime_r(&tt, &tmv);
  int y = tmv.tm_year, m = tmv.tm_mon;
  for (int guard = 0; guard < 240; guard++) {
    struct tm mt = {}; mt.tm_year = y; mt.tm_mon = m; mt.tm_mday = 1; mt.tm_isdst = -1;
    time_t ms = mktime(&mt);
    if ((uint32_t)ms > toT) break;
    char path[32];
    snprintf(path, sizeof(path), "/log/h_%04d-%02d.csv", y + 1900, m + 1);
    if (SD_MMC.exists(path)) {
      File f = SD_MMC.open(path, FILE_READ);
      if (f) {
        int ll = 0, n;
        uint32_t lastT = 0;
        while ((n = f.read((uint8_t*)rbuf, sizeof(rbuf))) > 0) {
          for (int i = 0; i < n; i++) {
            char c = rbuf[i];
            if (c == '\n') {
              line[ll] = 0; ll = 0;
              uint32_t t; HistAcc r;
              if (parseHourRow(line, t, r) && t > lastT && t >= fromT && t < toT) { lastT = t; cb(ctx, t, r); }
            } else if (c != '\r' && ll < (int)sizeof(line) - 1) line[ll++] = c;
          }
          delay(0);
        }
        f.close();
      }
    }
    if (++m > 11) { m = 0; y++; }
  }
}

// Verdichtete Ausgabe fuer Web und Display
static HistOut histWeb[HIST_WEB_MAX + 1];


void histEmit(HistBuild& h) {
  if (h.acc.n == 0 || h.n >= h.maxPts) return;
  HistOut& o = h.out[h.n];
  accOut(h.acc, o);
  o.gap = (h.n > 0) && (o.t - h.out[h.n - 1].t > h.gapLimit);
  h.n++;
}

void histFeed(HistBuild& h, uint32_t t, const HistAcc* row, const LogPoint* p) {
  int64_t b = ((int64_t)t - h.fromT) / h.bucket;
  if (b != h.curB) { histEmit(h); h.curB = b; accReset(h.acc); }
  if (row) accAddAcc(h.acc, *row); else accAddPoint(h.acc, *p);
}

void histHourCb(void* ctx, uint32_t t, const HistAcc& r) { histFeed(*(HistBuild*)ctx, t, &r, nullptr); }

int buildHistory(uint32_t fromT, uint32_t toT, int maxPts, HistOut* out, uint32_t* bucketOut, bool useSd) {
  if (!logBuf || toT <= fromT || maxPts < 2) return 0;
  uint32_t ramFirst = firstLoggedT();
  bool sdPart = useSd && sdOk && (!logCount || fromT < ramFirst);

  uint32_t span = toT - fromT;
  uint32_t bucket = (span + maxPts - 1) / maxPts;
  if (bucket < LOG_INTERVAL_SEC) bucket = LOG_INTERVAL_SEC;
  bucket = ((bucket + LOG_INTERVAL_SEC - 1) / LOG_INTERVAL_SEC) * LOG_INTERVAL_SEC;
  if (sdPart && bucket < 3600) bucket = 3600;               // Stundenmittel von SD
  if (bucketOut) *bucketOut = bucket;

  HistBuild h;
  h.fromT = fromT; h.bucket = bucket; h.maxPts = maxPts; h.n = 0; h.curB = -1; h.out = out;
  h.gapLimit = max(bucket * 3, LOG_INTERVAL_SEC * 4);
  if (sdPart) h.gapLimit = max(h.gapLimit, (uint32_t)3 * 3600);
  accReset(h.acc);

  if (sdPart) readHourRowsImpl(fromT, logCount ? min(toT, ramFirst) : toT, histHourCb, &h);

  xSemaphoreTake(logMutex, portMAX_DELAY);
  uint32_t cnt = logCount;
  uint32_t lo = 0, hi = cnt;                  // binaere Suche nach fromT
  while (lo < hi) {
    uint32_t mid = (lo + hi) / 2;
    if (logAt(mid).t < fromT) lo = mid + 1; else hi = mid;
  }
  for (uint32_t pos = lo; pos < cnt; pos++) {
    const LogPoint& p = logAt(pos);
    if (p.t > toT) break;
    if (!(p.flags & F_TEMPS)) continue;
    histFeed(h, p.t, nullptr, &p);
  }
  histEmit(h);
  xSemaphoreGive(logMutex);
  return h.n;
}

// =====================================================
// SD-Karte
// =====================================================
uint32_t lastSdTryMs = 0, lastSdFlushMs = 0, lastSdSpaceMs = 0;
uint64_t sdTotalBytes = 0, sdUsedBytes = 0;

void updateSdSpace() {
  if (!sdOk) return;
  sdTotalBytes = SD_MMC.totalBytes();
  sdUsedBytes  = SD_MMC.usedBytes();
  lastSdSpaceMs = millis();
}

bool mountSd() {
  if (!SD_MMC.begin("/sdcard", false, false, SDMMC_FREQ_DEFAULT, 5)) {
    return false;
  }
  if (SD_MMC.cardType() == CARD_NONE) { SD_MMC.end(); return false; }
  if (!SD_MMC.exists("/log")) SD_MMC.mkdir("/log");
  sdOk = true;
  updateSdSpace();
  if (SD_MMC.kind() == 1 && avDataFormatted) Log.println("Interner Speicher (QSPI-Partition 4) wurde neu eingerichtet");
  Log.printf("%s OK: %llu KB, belegt %llu KB\n", SD_MMC.kindName(), sdTotalBytes >> 10, sdUsedBytes >> 10);
  return true;
}

void sdFail(const char* why) {
  Log.printf("SD Fehler: %s -> SD deaktiviert, neuer Versuch spaeter\n", why);
  sdOk = false;
  SD_MMC.end();
  lastSdTryMs = millis();
}

void dayFileName(uint32_t t, char* out, size_t n) {
  time_t tt = t; struct tm tmv; localtime_r(&tt, &tmv);
  snprintf(out, n, "/log/%04d-%02d-%02d.csv", tmv.tm_year + 1900, tmv.tm_mon + 1, tmv.tm_mday);
}

void fmtTenth(char* out, size_t n, int v) {     // 285 -> "28,5"  (Excel-DE)
  const char* s = v < 0 ? "-" : "";
  int a = abs(v);
  snprintf(out, n, "%s%d,%d", s, a / 10, a % 10);
}

int formatCsvLine(char* out, size_t n, const LogPoint& p) {
  time_t tt = p.t; struct tm tmv; localtime_r(&tt, &tmv);
  char vl[10], rl[10], ww[10], fl[10] = "", hz[6] = "", f1[8] = "", f2[8] = "", sv[6] = "", wp[3] = "", md[4] = "", rt[10] = "";
  char ta[10] = "", ev[10] = "", pel[8] = "", pth[8] = "", df[3] = "", wl[3], pv[8] = "", gr[8] = "", pwp[8] = "", psh[8] = "";
  if (p.rt != INT16_MIN)     fmtTenth(rt, sizeof(rt), p.rt);
  fmtTenth(vl, sizeof(vl), p.vl);
  fmtTenth(rl, sizeof(rl), p.rl);
  fmtTenth(ww, sizeof(ww), p.ww);
  if (p.flags & F_FLOW)      fmtTenth(fl, sizeof(fl), p.flow);
  if (p.flags & F_HZ)        snprintf(hz, sizeof(hz), "%u", p.hz);
  if (p.flags & F_FAN)     { snprintf(f1, sizeof(f1), "%u", p.fan1); snprintf(f2, sizeof(f2), "%u", p.fan2); }
  if (p.flags & F_SV)        snprintf(sv, sizeof(sv), "%u", p.sv);
  if (p.flags & F_WPVALID)   snprintf(wp, sizeof(wp), "%u", (p.flags & F_WPON) ? 1 : 0);
  if (p.flags & F_MODEVALID) snprintf(md, sizeof(md), "%u", p.mode);
  if (p.ta != INT16_MIN)   { fmtTenth(ta, sizeof(ta), p.ta); fmtTenth(ev, sizeof(ev), p.evap); }
  if (p.f2 & F2_EXT)       { snprintf(pel, sizeof(pel), "%d", p.pEl); snprintf(pth, sizeof(pth), "%d", p.pTh);
                             snprintf(df, sizeof(df), "%u", (p.f2 & F2_DEFROST) ? 1 : 0); }
  snprintf(wl, sizeof(wl), "%u", (p.f2 & F2_WWLOAD) ? 1 : 0);
  if (p.pv != 0xFFFF)        snprintf(pv, sizeof(pv), "%u", p.pv);
  if (p.grid != INT16_MIN)   snprintf(gr, sizeof(gr), "%d", p.grid);
  if (p.pElWp != INT16_MIN)  snprintf(pwp, sizeof(pwp), "%d", p.pElWp);
  if (p.pElSh != INT16_MIN)  snprintf(psh, sizeof(psh), "%d", p.pElSh);
  return snprintf(out, n, "%lu;%02d.%02d.%04d %02d:%02d:%02d;%s;%s;%s;%s;%s;%s;%s;%s;%s;%s;%s;%s;%s;%s;%s;%s;%s;%s;%s;%s;%s\n",
                  (unsigned long)p.t, tmv.tm_mday, tmv.tm_mon + 1, tmv.tm_year + 1900,
                  tmv.tm_hour, tmv.tm_min, tmv.tm_sec,
                  vl, rl, ww, hz, fl, f1, f2, sv, wp, md, rt, ta, ev, pel, pth, df, wl, pv, gr, pwp, psh);
}

static const char CSV_HEADER[] =
  "epoch_utc;Zeit;Vorlauf;Ruecklauf;Warmwasser;Verdichter_Hz;Durchfluss_Lmin;"
  "Luefter1_rpm;Luefter2_rpm;Sollwert;WP_Ein;Modus;Raum;"
  "Aussen;Verdampfer;P_el_W;P_th_W;Abtauen;WW_Ladung;PV_W;Netz_W;P_el_WP_W;P_el_Shelly_W\n";

// Schreibt alle noch nicht gesicherten Punkte (nur aus loop() aufrufen)
void sdFlush() {
  if (!sdOk || !logBuf) return;
  uint32_t pending = logTotal - sdFlushedTotal;
  if (pending == 0) return;
  if (pending > logCount) { sdFlushedTotal = logTotal - logCount; }

  File f;
  char curPath[32] = "";
  char line[220];

  for (uint32_t k = sdFlushedTotal; k < logTotal; k++) {
    // loop() ist der einzige Schreiber des Puffers -> Lesen ohne Lock ok
    LogPoint p = logAt(logCount - (logTotal - k));
    char path[32];
    dayFileName(p.t, path, sizeof(path));
    if (strcmp(path, curPath) != 0) {
      if (f) f.close();
      f = SD_MMC.open(path, FILE_APPEND);
      if (!f) { sdFail("Datei oeffnen"); return; }
      strlcpy(curPath, path, sizeof(curPath));
      if (f.size() == 0) f.print(CSV_HEADER);
    }
    int len = formatCsvLine(line, sizeof(line), p);
    if (f.write((const uint8_t*)line, len) != (size_t)len) { f.close(); sdFail("Schreiben"); return; }
    sdFlushedTotal = k + 1;
  }
  if (f) f.close();
}

// ---- CSV-Zeile -> Messpunkt (fuer Neustart und Tagesauswertung) ----
int16_t parseTenth(char* s, bool& ok) {
  ok = (s && *s);
  if (!ok) return 0;
  for (char* c = s; *c; c++) if (*c == ',') *c = '.';
  float v = strtof(s, nullptr);
  return (int16_t)lroundf(v * 10.0f);
}

bool parseCsvLine(char* line, LogPoint& p) {
  if (line[0] < '0' || line[0] > '9') return false;   // Kopfzeile
  char* fld[23]; int nf = 0;
  char* s = line;
  while (nf < 23) {
    fld[nf++] = s;
    char* sep = strchr(s, ';');
    if (!sep) break;
    *sep = 0; s = sep + 1;
  }
  if (nf < 5) return false;

  logPointInit(p);
  p.t = strtoul(fld[0], nullptr, 10);
  bool ok1, ok2, ok3, ok;
  p.vl = parseTenth(fld[2], ok1);
  p.rl = parseTenth(fld[3], ok2);
  p.ww = parseTenth(fld[4], ok3);
  if (!(ok1 && ok2 && ok3)) return false;
  p.flags = F_TEMPS;

  if (nf > 5  && *fld[5])  { p.hz = (uint8_t)min(255L, atol(fld[5])); p.flags |= F_HZ; }
  if (nf > 6)              { p.flow = parseTenth(fld[6], ok); if (ok) p.flags |= F_FLOW; }
  if (nf > 8  && *fld[7])  { p.fan1 = atoi(fld[7]); p.fan2 = atoi(fld[8]); p.flags |= F_FAN; }
  if (nf > 9  && *fld[9])  { p.sv = (uint8_t)atoi(fld[9]); p.flags |= F_SV; }
  if (nf > 10 && *fld[10]) { p.flags |= F_WPVALID; if (atoi(fld[10])) p.flags |= F_WPON; }
  if (nf > 11 && *fld[11]) { p.mode = (uint8_t)atoi(fld[11]); p.flags |= F_MODEVALID; }
  if (nf > 12 && *fld[12]) { p.rt = parseTenth(fld[12], ok); if (!ok) p.rt = INT16_MIN; }
  if (nf > 14 && *fld[13]) { p.ta = parseTenth(fld[13], ok); p.evap = parseTenth(fld[14], ok); }
  if (nf > 17 && *fld[15]) { p.pEl = atoi(fld[15]); p.pTh = atoi(fld[16]); p.f2 |= F2_EXT;
                             if (atoi(fld[17])) p.f2 |= F2_DEFROST; }
  if (nf > 18 && atoi(fld[18])) p.f2 |= F2_WWLOAD;
  if (nf > 19 && *fld[19]) p.pv = (uint16_t)constrain(atol(fld[19]), 0L, 65000L);
  if (nf > 20 && *fld[20]) p.grid = (int16_t)constrain(atol(fld[20]), -32000L, 32000L);
  if (nf > 21 && *fld[21]) p.pElWp = (int16_t)constrain(atol(fld[21]), 0L, 32000L);
  if (nf > 22 && *fld[22] && *fld[22] != '\r' && *fld[22] != '\n') p.pElSh = (int16_t)constrain(atol(fld[22]), 0L, 32000L);
  return true;
}

void restoreLine(char* line, uint32_t minT, uint32_t maxT) {
  LogPoint p;
  if (!parseCsvLine(line, p)) return;
  if (p.t < minT || p.t > maxT || p.t <= lastLoggedT()) return;
  logPush(p);
}

void restoreHistoryFromSd() {
  if (!sdOk || !logBuf || !timeValid()) return;
  restoringHistory = true;
  uint32_t t0 = millis();
  uint32_t now = nowUtc();
  uint32_t capSec = logCap * LOG_INTERVAL_SEC;
  uint32_t minT = now - capSec;
  uint32_t days = capSec / 86400UL + 1;

  static char rbuf[4096];
  char line[240];

  for (int32_t d = days; d >= 0; d--) {
    char path[32];
    dayFileName(now - d * 86400UL, path, sizeof(path));
    if (!SD_MMC.exists(path)) continue;
    File f = SD_MMC.open(path, FILE_READ);
    if (!f) continue;
    int ll = 0;
    int n;
    while ((n = f.read((uint8_t*)rbuf, sizeof(rbuf))) > 0) {
      for (int i = 0; i < n; i++) {
        char c = rbuf[i];
        if (c == '\n') { line[ll] = 0; restoreLine(line, minT, now + 60); ll = 0; }
        else if (c != '\r' && ll < (int)sizeof(line) - 1) line[ll++] = c;
      }
      delay(0);
    }
    if (ll) { line[ll] = 0; restoreLine(line, minT, now + 60); }
    f.close();
  }
  sdFlushedTotal = logTotal;               // nicht nochmal schreiben
  lastLogSlot = lastLoggedT() / LOG_INTERVAL_SEC;
  restoringHistory = false;
  Log.printf("Verlauf von SD geladen: %lu Punkte in %lu ms\n",
                (unsigned long)logCount, (unsigned long)(millis() - t0));
}

// Wird in loop() aufgerufen
void dfFlush();
void loggingTick() {
  if (!logBuf || !timeValid()) return;
  dfFlush();

  if (!historyRestored) {
    if (!storageReady) return;                   // erst evtl. fehlende Daten vom NAS holen
    historyRestored = true;
    restoreHistoryFromSd();
  }

  uint32_t now = nowUtc();
  uint32_t slot = now / LOG_INTERVAL_SEC;        // an Uhrzeit ausgerichtet -> kein Drift
  if (slot == lastLogSlot) return;
  lastLogSlot = slot;

  LiveData d = getLive();
  if (!d.tempsValid) return;                       // keine Phantomwerte loggen

  LogPoint p;
  logPointInit(p);
  p.t     = slot * LOG_INTERVAL_SEC;
  if (p.t <= lastLoggedT()) return;
  p.vl    = (int16_t)lroundf(d.vorlauf * 10.0f);
  p.rl    = (int16_t)lroundf(d.ruecklauf * 10.0f);
  p.ww    = (int16_t)lroundf(d.warmwasser * 10.0f);
  p.flags = F_TEMPS;
  if (d.hzValid)      { p.hz = (uint8_t)min((uint16_t)255, d.verdichterHz); p.flags |= F_HZ; }
  if (d.flowValid)    { p.flow = (int16_t)lroundf(d.flowLmin * 10.0f); p.flags |= F_FLOW; }
  if (d.fanRpmValid)  { p.fan1 = d.fan1Rpm; p.fan2 = d.fan2Rpm; p.flags |= F_FAN; }
  if (d.sollValid)    { p.sv = (uint8_t)constrain((int)lroundf(d.sollwert), 0, 255); p.flags |= F_SV; }
  if (d.wpStateValid) { p.flags |= F_WPVALID; if (d.wpOnOffRaw) p.flags |= F_WPON; }
  if (d.wpModeValid)  { p.mode = (uint8_t)d.wpModeRaw; p.flags |= F_MODEVALID; }
  p.rt = rtValid() ? (int16_t)lroundf(rtIst * 10.0f) : INT16_MIN;
  if (d.extValid) {
    p.ta   = (int16_t)lroundf(d.ta * 10.0f);
    p.evap = (int16_t)lroundf(d.evap * 10.0f);
    p.pEl  = (int16_t)constrain(lroundf(d.pEl), 0L, 32000L);
    p.pElWp = (int16_t)constrain(lroundf(d.pElWp), 0L, 32000L);
    p.pTh  = (int16_t)constrain(lroundf(d.pTh), -32000L, 32000L);
    p.f2  |= F2_EXT;
    if (d.state & 16) p.f2 |= F2_DEFROST;
  }
  if (wwState == WW_MOVE || wwState == WW_HEAT) p.f2 |= F2_WWLOAD;
  float pw = pvGet(pvPower, 120000UL), gr = pvGet(pvGrid, 120000UL);
  if (!isnan(pw)) p.pv = (uint16_t)constrain(lroundf(pw), 0L, 65000L);
  if (!isnan(gr)) p.grid = (int16_t)constrain(lroundf(gr), -32000L, 32000L);
  if (shFresh()) p.pElSh = (int16_t)constrain(lroundf((float)shP), 0L, 32000L);   // Shelly immer mitloggen
  logPush(p);
}

// Konsole zusaetzlich nach /log/console.txt schreiben (alle 10 s)
static uint32_t consoleSaved = 0;
static bool     consoleBootMark = false;
static uint32_t lastConsoleMs = 0;

void consoleFlush() {
  if (!sdOk) return;
  uint32_t total;
  portENTER_CRITICAL(&logMux); total = logRingTotal; portEXIT_CRITICAL(&logMux);
  if (total == consoleSaved && consoleBootMark) return;
  File f = SD_MMC.open("/log/console.txt", FILE_APPEND);
  if (!f) return;
  if (!consoleBootMark) { f.print("\n===== Neustart =====\n"); consoleBootMark = true; }
  if (total - consoleSaved > sizeof(logRing)) {          // Teil verloren (Puffer uebergelaufen)
    f.print("\n[... Konsole uebergelaufen ...]\n");
    consoleSaved = total - sizeof(logRing);
  }
  char buf[512];
  while (consoleSaved < total) {
    uint32_t n = min((uint32_t)sizeof(buf), total - consoleSaved);
    portENTER_CRITICAL(&logMux);
    for (uint32_t i = 0; i < n; i++) buf[i] = logRing[(consoleSaved + i) % sizeof(logRing)];
    portEXIT_CRITICAL(&logMux);
    f.write((const uint8_t*)buf, n);
    consoleSaved += n;
  }
  size_t sz = f.size();
  f.close();
  if (sz > (SD_MMC.kind() == 1 ? 192UL * 1024 : 2UL * 1024 * 1024)) {   // zu gross: umbenennen, neu anfangen (intern nur 192 KB)
    SD_MMC.remove("/log/console_alt.txt");
    SD_MMC.rename("/log/console.txt", "/log/console_alt.txt");
  }
}

void sdTick() {
  uint32_t ms = millis();
  if (sdOk && ms - lastConsoleMs >= 60000) { lastConsoleMs = ms; consoleFlush(); }   // GIGA: seltener auf den Stick
  if (!sdOk) {
    if (ms - lastSdTryMs >= SD_RETRY_MS) {
      lastSdTryMs = ms;
      if (mountSd()) lastSdFlushMs = ms - SD_FLUSH_MS;   // gleich nachschreiben
    }
    return;
  }
  if (ms - lastSdFlushMs >= SD_FLUSH_MS) {
    lastSdFlushMs = ms;
    sdFlush();
  }
  if (sdOk && ms - lastSdSpaceMs >= 3600000UL) updateSdSpace();
}

// =====================================================
// Modbus (laeuft NUR im Modbus-Task)
// =====================================================
void clearSerial1Buffer() { while (Serial1.available()) Serial1.read(); }

void preTransmission() {
  if (mbCfg.mode == 0 && mbCfg.de >= 0) digitalWrite(mbCfg.de, HIGH);
  delay(1);
}

// expectId: ID des angefragten Geraets. Ein Byte mit genau dieser ID ist schon der
// Anfang der Antwort (das Ventilmodul antwortet teils nach < 3 ms) und bleibt stehen.
void postTxDiscard(uint8_t expectId) {
  Serial1.flush();                       // warten bis das letzte Byte raus ist
  delayMicroseconds(11000000UL / mbCfg.baud + 100);   // GIGA: flush() wartet nur bis zum Schieberegister
  if (mbCfg.mode == 0 && mbCfg.de >= 0) digitalWrite(mbCfg.de, LOW);
  // Beim Umschalten Senden->Empfangen entsteht oft ein Stoerbyte (-> Fehler 224).
  // Ein Byte braucht bei 9600 Baud ~1 ms, also kurz warten und DANN verwerfen.
  if (mbCfg.gap) delay(mbCfg.gap);
  uint8_t junk[8]; int nj = 0;
  while (Serial1.available()) {
    if (Serial1.peek() == expectId) break;          // Antwort beginnt -> behalten
    int c = Serial1.read(); if (nj < 8) junk[nj] = (uint8_t)c; nj++;
  }
  if (nj && verbose) {
    Log.printf("Modbus: %d Stoerbyte(s) verworfen:", nj);
    for (int i = 0; i < min(nj, 8); i++) Log.printf(" %02X", junk[i]);
    Log.println();
  }
}
void postTransmission() { postTxDiscard(mbCfg.id); }

void mbSetup() {
  if (mbCfg.de >= 0) { pinMode(mbCfg.de, OUTPUT); digitalWrite(mbCfg.de, LOW); }
  mbCfg.mode = 0;                        // GIGA: DE immer per Software (feste Pins D0/D1)
  Serial1.begin(mbCfg.baud);             // 8N1, RX mit Pull-up
  node.begin(mbCfg.id, Serial1);
  node.preTransmission(preTransmission);
  node.postTransmission(postTransmission);
  node.idle([]() { vTaskDelay(1); });    // beim Warten auf Antwort CPU freigeben
  Log.printf("Modbus: RX=IO%d TX=IO%d DE=IO%d, %s, %lu Baud, Slave %u, Pause %u ms\n",
             mbCfg.rx, mbCfg.tx, mbCfg.de, mbCfg.mode ? "Hardware-RS485" : "DE per Software",
             (unsigned long)mbCfg.baud, mbCfg.id, mbCfg.gap);
}

volatile uint8_t mbFailStreak = 0;     // aufeinanderfolgende Fehlversuche (WP nicht erreichbar?)

uint8_t readRegsRetry(uint16_t startReg, uint8_t count) {
  uint8_t result = 255;
  uint8_t tries = mbFailStreak >= 3 ? 1 : 3;   // offline: nicht jede Abfrage 3x 2 s blockieren
  for (uint8_t attempt = 0; attempt < tries; attempt++) {
    clearSerial1Buffer();
    result = node.readHoldingRegisters(startReg, count);
    if (result == node.ku8MBSuccess) { mbFailStreak = 0; return result; }
    delay(180);
  }
  if (mbFailStreak < 255) mbFailStreak++;
  liveLock(); live.lastErr = result; live.lastErrMs = millis(); liveUnlock();
  return result;
}

uint8_t writeRegRetry(uint16_t reg, uint16_t value) {
  uint8_t result = 255;
  for (uint8_t attempt = 0; attempt < 3; attempt++) {
    clearSerial1Buffer();
    result = node.writeSingleRegister(reg, value);
    if (result == node.ku8MBSuccess) return result;
    delay(250);
  }
  liveLock(); live.lastErr = result; live.lastErrMs = millis(); liveUnlock();
  return result;
}

static inline void countOk()  { liveLock(); live.okCount++;  liveUnlock(); }

// ---------- Installateur-Parameter (Block 0x2000, Adresse = 8192 + P - 2) ----------
// 8194 P105 Plattformfrequenz Verdichter (Hz), 8195 P106 Plattform-Verzoegerung,
// 8196 P06 Hysterese Heizen (0,1 K), 8197 P07 Hysterese Warmwasser (0,1 K)
static const uint16_t REG_PAR_BASE = 8194;
volatile uint16_t wpPar[4] = {0, 0, 0, 0};
volatile bool     wpParValid = false;
volatile uint32_t wpParMs = 0;
volatile uint8_t  rawReadN = 1;            // Konsole "RD": Anzahl Register
bool readWpParams();
static inline void countErr() { liveLock(); live.errCount++; liveUnlock(); }

bool readWpParams() {
  uint8_t r = readRegsRetry(REG_PAR_BASE, 4);
  if (r != node.ku8MBSuccess) {
    countErr();
    Log.printf("Fehler Parameter lesen (8194..8197): %u (%s)\n", r, mbErrText(r));
    return false;
  }
  countOk();
  bool changed = !wpParValid;
  for (int i = 0; i < 4; i++) {
    uint16_t v = node.getResponseBuffer(i);
    if (v != wpPar[i]) changed = true;
    wpPar[i] = v;
  }
  wpParValid = true; wpParMs = millis();
  if (changed) Log.printf("WP-Parameter: P105 Plattform %u Hz, P106 Verzoegerung %u, P06 Hyst. Heizen %.1f K (roh %u), P07 Hyst. WW %.1f K (roh %u)\n",
                          wpPar[0], wpPar[1], wpPar[2] / 10.0f, wpPar[2], wpPar[3] / 10.0f, wpPar[3]);
  return true;
}

bool setWpParam(uint16_t reg, uint16_t raw, const char* name) {
  Log.printf("Schreibe %s: Register %u = %u\n", name, reg, raw);
  uint8_t r = writeRegRetry(reg, raw);
  if (r != node.ku8MBSuccess) {
    countErr();
    Log.printf("Fehler %s schreiben: %u (%s)\n", name, r, mbErrText(r));
    setCmdMsg("%s schreiben FEHLER", name);
    return false;
  }
  delay(800);
  readWpParams();
  bool ok = wpParValid && wpPar[reg - REG_PAR_BASE] == raw;
  Log.printf("%s Ruecklesen: %u %s\n", name, wpPar[reg - REG_PAR_BASE], ok ? "OK" : "-> NICHT uebernommen");
  setCmdMsg("%s %s", name, ok ? "geschrieben" : "nicht uebernommen");
  return ok;
}

bool readRawRegs(uint16_t addr, uint8_t n) {
  n = constrain(n, 1, 20);
  uint8_t r = readRegsRetry(addr, n);
  if (r != node.ku8MBSuccess) { Log.printf("RD %u: Fehler %u (%s)\n", addr, r, mbErrText(r)); return false; }
  Log.printf("RD %u..%u:", addr, addr + n - 1);
  for (int i = 0; i < n; i++) Log.printf(" %u", node.getResponseBuffer(i));
  Log.println();
  return true;
}

bool readWpStateAndMode() {
  uint8_t r = readRegsRetry(REG_ONOFF, 2);
  if (r == node.ku8MBSuccess) {
    uint16_t onoff = node.getResponseBuffer(0), mode = node.getResponseBuffer(1);
    liveLock();
    live.wpOnOffRaw = onoff; live.wpModeRaw = mode;
    live.wpStateValid = live.wpModeValid = true;
    live.okCount++;
    liveUnlock();
    MBLOG("WP OK   | OnOff=%u Mode=%u %s\n", onoff, mode, modeName(mode));
    return true;
  }
  countErr();
  Log.printf("Fehler WP Status lesen (4096..4097): %u (%s)\n", r, mbErrText(r));
  return false;
}

bool readTemps() {
  uint8_t r = readRegsRetry(REG_RL, 3);
  if (r == node.ku8MBSuccess) {
    float rl = (int16_t)node.getResponseBuffer(0) / 10.0f;
    float vl = (int16_t)node.getResponseBuffer(1) / 10.0f;
    float ww = (int16_t)node.getResponseBuffer(2) / 10.0f;
    liveLock();
    live.ruecklauf = rl; live.vorlauf = vl; live.warmwasser = ww;
    live.tempsValid = true; live.okCount++;
    liveUnlock();
    MBLOG("Temps OK | RL=%.1f  VL=%.1f  WW=%.1f\n", rl, vl, ww);
    return true;
  }
  countErr();
  Log.printf("Fehler Temps (4365..4367): %u (%s)\n", r, mbErrText(r));
  return false;
}

bool readFlow() {
  uint8_t r = readRegsRetry(REG_FLOW, 1);
  if (r == node.ku8MBSuccess) {
    uint16_t raw = node.getResponseBuffer(0);
    liveLock();
    live.flowRaw = raw; live.flowLmin = raw / 10.0f; live.flowValid = true; live.okCount++;
    liveUnlock();
    MBLOG("Flow OK  | Reg 4368 raw=%u -> %.1f L/min\n", raw, raw / 10.0f);
    return true;
  }
  countErr();
  Log.printf("Fehler Flow lesen (4368): %u (%s)\n", r, mbErrText(r));
  return false;
}

bool readHz() {
  uint8_t r = readRegsRetry(REG_HZ, 1);
  if (r == node.ku8MBSuccess) {
    uint16_t hz = node.getResponseBuffer(0);
    liveLock();
    live.verdichterHz = hz; live.hzValid = true; live.okCount++;
    liveUnlock();
    MBLOG("Hz OK    | VD=%u\n", hz);
    return true;
  }
  countErr();
  Log.printf("Fehler Hz (4373): %u (%s)\n", r, mbErrText(r));
  return false;
}

bool readFanRpm() {
  uint8_t r = readRegsRetry(REG_FAN1_RPM, 2);
  if (r == node.ku8MBSuccess) {
    uint16_t f1 = node.getResponseBuffer(0), f2 = node.getResponseBuffer(1);
    liveLock();
    live.fan1Rpm = f1; live.fan2Rpm = f2; live.fanRpmValid = true; live.okCount++;
    liveUnlock();
    MBLOG("Fan OK   | Fan1=%u rpm  Fan2=%u rpm\n", f1, f2);
    return true;
  }
  countErr();
  Log.printf("Fehler Fan RPM lesen (4374..4375): %u (%s)\n", r, mbErrText(r));
  return false;
}

// ---------- Blocklesen: alle Temperaturen, Druecke, Strom ... in einer Abfrage ----------
volatile bool blockReadOk = true;      // false, wenn die WP Blocklesen ablehnt -> Einzelabfragen
uint16_t rawBlock[33];                 // Rohwerte 4354..4386 (Diagnose im Web)
uint16_t rawCnt[5];                    // Rohwerte 4608..4612
volatile bool rawBlockValid = false, rawCntValid = false;
uint8_t  gridPhases = 3;               // Netzanschluss WP: 1 oder 3 Phasen
uint16_t pElFactor = 100;              // Korrektur el. Leistung in % (Abgleich mit echtem Zaehler)
bool shFresh() { return shMs && millis() - shMs < SH_MAX_AGE && !isnan((float)shP); }
static uint32_t lastEnergyMs = 0;
static int      lastEnergyDay = -1;

void energyAccumulate(LiveData& L) {   // unter liveLock aufrufen
  uint32_t ms = millis();
  if (lastEnergyMs && ms - lastEnergyMs < 60000UL) {
    double h = (ms - lastEnergyMs) / 3600000.0;
    if (L.pEl > 0) { L.eElDay += L.pEl * h; L.eElTot += L.pEl * h; }
    if (L.pTh > 0) { L.eThDay += L.pTh * h; L.eThTot += L.pTh * h; }
  }
  lastEnergyMs = ms;
  if (timeValid()) {
    time_t tt = time(nullptr); struct tm tmv; localtime_r(&tt, &tmv);
    if (lastEnergyDay >= 0 && tmv.tm_yday != lastEnergyDay) {
      bool yesterday = (tmv.tm_yday == lastEnergyDay + 1) || (tmv.tm_yday == 0 && lastEnergyDay >= 364);
      L.eElYest = yesterday ? L.eElDay : 0; L.eThYest = yesterday ? L.eThDay : 0;
      L.eElDay = 0; L.eThDay = 0;
    }
    lastEnergyDay = tmv.tm_yday;
  }
}

bool readStatusBlock() {
  uint8_t r = readRegsRetry(4354, 33);            // 4354 .. 4386
  if (r != node.ku8MBSuccess) {
    countErr();
    Log.printf("Fehler Statusblock (4354..4386): %u (%s)\n", r, mbErrText(r));
    if (r >= 1 && r <= 4) { blockReadOk = false; Log.println("WP lehnt Blocklesen ab -> Einzelabfragen"); }
    return false;
  }
  auto S = [](uint16_t a) -> int16_t { return (int16_t)node.getResponseBuffer(a - 4354); };
  for (int i = 0; i < 33; i++) rawBlock[i] = node.getResponseBuffer(i);
  rawBlockValid = true;
  liveLock();
  LiveData& L = live;
  L.state = S(4354); L.outputs = S(4355); L.inputs = S(4356);
  L.coil = S(4358) / 10.0f;   L.discharge = S(4359) / 10.0f; L.ta = S(4360) / 10.0f;
  L.suction = S(4361) / 10.0f; L.eviIn = S(4362) / 10.0f;   L.eviOut = S(4363) / 10.0f;
  L.liquid = S(4364) / 10.0f;
  L.ruecklauf = S(4365) / 10.0f; L.vorlauf = S(4366) / 10.0f; L.warmwasser = S(4367) / 10.0f;
  L.tempsValid = true;
  L.flowRaw = (uint16_t)S(4368); L.flowLmin = L.flowRaw / 10.0f; L.flowValid = true;
  L.dT = S(4369) / 10.0f;
  L.hp = S(4371) / 100.0f; L.lp = S(4372) / 100.0f;
  L.verdichterHz = (uint16_t)S(4373); L.hzValid = true;
  L.fan1Rpm = (uint16_t)S(4374); L.fan2Rpm = (uint16_t)S(4375); L.fanRpmValid = true;
  L.targetHz = (uint16_t)S(4378);
  L.currentA = S(4379) / 10.0f; L.ipm = S(4380);    // IPM in ganzen Grad (WP-Display: TPM 17)
  L.acV = S(4381); L.dcV = S(4382);       // Volt ohne Nachkomma (Anzeige zeigte 24 statt 240)
  L.t6 = S(4383) / 10.0f; L.room = S(4384) / 10.0f;
  L.evap = S(4385) / 10.0f; L.cond = S(4386) / 10.0f;
  // el. Leistung (Schaetzung): Strom x Spannung x cos phi; bei Drehstrom x3 (L-N) bzw. x1,73 (L-L)
  float u = (L.acV > 150 && L.acV < 480) ? L.acV : 230.0f;
  float k = (gridPhases == 3) ? (u > 300 ? 1.732f : 3.0f) : 1.0f;
  L.pElWp = (L.verdichterHz > 0 && L.currentA > 0) ? k * u * L.currentA * 0.95f * pElFactor / 100.0f : 0;
  L.pElSh = shFresh() ? max(0.0f, (float)shP) : NAN;
  L.pElSrc = (elSrc == 1 && !isnan(L.pElSh)) ? 1 : 0;     // Shelly fehlt -> automatisch Schaetzung
  L.pEl = L.pElSrc ? L.pElSh : L.pElWp;
  if (!isnan(L.pElSh) && L.verdichterHz > 0 && L.pElWp > 200) {     // fuer "Vorschlag Korrektur"
    shCmpSh += L.pElSh; shCmpWp += L.pElWp * 100.0f / pElFactor;     // Schaetzung ohne Korrektur
  }
  L.pTh = (L.flowLmin > 1.0f) ? L.flowLmin / 60.0f * 4186.0f * (L.vorlauf - L.ruecklauf) : 0;
  L.extValid = true;
  energyAccumulate(L);
  L.okCount++;
  float vl = L.vorlauf, rl = L.ruecklauf, ww = L.warmwasser, ta = L.ta;
  liveUnlock();
  MBLOG("Block OK | VL=%.1f RL=%.1f WW=%.1f Aussen=%.1f\n", vl, rl, ww, ta);
  return true;
}

bool readCounterBlock() {
  uint8_t r = readRegsRetry(4608, 5);             // 4608 .. 4612
  if (r != node.ku8MBSuccess) {
    countErr();
    Log.printf("Fehler Zaehlerblock (4608..4612): %u (%s)\n", r, mbErrText(r));
    return false;
  }
  liveLock();
  for (int i = 0; i < 5; i++) rawCnt[i] = node.getResponseBuffer(i);
  rawCntValid = true;
  live.starts = node.getResponseBuffer(0);
  live.runtimeH = node.getResponseBuffer(2);
  live.pumpPct = node.getResponseBuffer(3);
  live.opMode = node.getResponseBuffer(4);
  live.cntValid = true;
  live.okCount++;
  liveUnlock();
  return true;
}

bool readSollwert() {
  uint8_t r = readRegsRetry(REG_SOLL, 1);
  if (r == node.ku8MBSuccess) {
    uint16_t raw = node.getResponseBuffer(0);
    liveLock();
    live.sollwert = raw; live.sollValid = true; live.okCount++;
    liveUnlock();
    MBLOG("Soll OK  | 4098 raw=%u  -> %.1f\n", raw, (float)raw);
    return true;
  }
  countErr();
  Log.printf("Fehler Soll lesen (4098): %u (%s)\n", r, mbErrText(r));
  return false;
}

bool readMaxHzValue(uint16_t& value) {
  uint8_t r = readRegsRetry(REG_MAX_HZ, 1);
  if (r == node.ku8MBSuccess) {
    value = node.getResponseBuffer(0);
    liveLock();
    live.maxVerdichterHz = value; live.maxHzValid = true; live.okCount++;
    liveUnlock();
    return true;
  }
  countErr();
  Log.printf("Fehler MaxHz lesen (8235/P45): %u (%s)\n", r, mbErrText(r));
  return false;
}

bool readMaxHz() {
  uint16_t v;
  if (!readMaxHzValue(v)) return false;
  MBLOG("MaxHz OK | P45=%u\n", v);
  return true;
}

bool readMaxFanValue(uint16_t& valueRpm) {
  uint8_t r = readRegsRetry(REG_MAX_FAN_RPM, 1);
  if (r == node.ku8MBSuccess) {
    uint16_t raw = node.getResponseBuffer(0);
    valueRpm = raw * 10;
    liveLock();
    live.maxFanRaw = raw; live.maxFanRpm = valueRpm; live.maxFanValid = true; live.okCount++;
    liveUnlock();
    return true;
  }
  countErr();
  Log.printf("Fehler MaxFan lesen (8250/P60): %u (%s)\n", r, mbErrText(r));
  return false;
}

bool readMaxFan() {
  uint16_t v;
  if (!readMaxFanValue(v)) return false;
  MBLOG("MaxFan OK | P60 raw=%u -> %u rpm\n", v / 10, v);
  return true;
}

// ---------- Schreiben ----------
bool setSollwert(float tempC) {
  uint16_t raw = (uint16_t)(tempC + 0.5f);
  Log.printf("Schreibe 4098 = %u (%.1f C)\n", raw, tempC);
  uint8_t r = writeRegRetry(REG_SOLL, raw);
  if (r == node.ku8MBSuccess) {
    Log.println("Schreiben OK");
    delay(500);
    readSollwert();
    setCmdMsg("Sollwert %u C geschrieben", raw);
    return true;
  }
  countErr();
  Log.printf("Fehler Soll schreiben (4098): %u (%s)\n", r, mbErrText(r));
  setCmdMsg("Sollwert schreiben FEHLER");
  return false;
}

bool setMaxHz(uint16_t hz) {
  if (hz < MAX_HZ_MIN || hz > MAX_HZ_MAX) {
    Log.printf("Ungueltig. MaxHz nur %u..%u erlaubt.\n", MAX_HZ_MIN, MAX_HZ_MAX);
    return false;
  }
  Log.printf("SetMaxHz Ziel = %u Hz\n", hz);
  for (uint8_t attempt = 1; attempt <= 5; attempt++) {
    Log.printf("MaxHz Versuch %u/5: schreibe P45 = %u\n", attempt, hz);
    uint8_t r = writeRegRetry(REG_MAX_HZ, hz);
    if (r != node.ku8MBSuccess) {
      countErr();
      Log.printf("Fehler MaxHz schreiben (8235/P45): %u (%s)\n", r, mbErrText(r));
      delay(600);
      continue;
    }
    delay(1200);
    uint16_t rb = 0;
    if (readMaxHzValue(rb)) {
      Log.printf("MaxHz Ruecklesen = %u\n", rb);
      if (rb == hz) {
        Log.println("MaxHz wirklich uebernommen");
        setCmdMsg("MaxHz %u uebernommen", hz);
        return true;
      }
    }
    delay(800);
  }
  Log.println("MaxHz NICHT sicher uebernommen");
  setCmdMsg("MaxHz NICHT uebernommen");
  return false;
}

bool setMaxFan(uint16_t rpm) {
  if (rpm < FAN_RPM_MIN || rpm > FAN_RPM_MAX) {
    Log.printf("Ungueltig. MaxFan nur %u..%u rpm erlaubt.\n", FAN_RPM_MIN, FAN_RPM_MAX);
    return false;
  }
  uint16_t raw = (rpm + 5) / 10;
  Log.printf("SetMaxFan Ziel = %u rpm, schreibe raw=%u\n", rpm, raw);
  for (uint8_t attempt = 1; attempt <= 5; attempt++) {
    Log.printf("MaxFan Versuch %u/5: schreibe P60 raw=%u\n", attempt, raw);
    uint8_t r = writeRegRetry(REG_MAX_FAN_RPM, raw);
    if (r != node.ku8MBSuccess) {
      countErr();
      Log.printf("Fehler MaxFan schreiben (8250/P60): %u (%s)\n", r, mbErrText(r));
      delay(600);
      continue;
    }
    delay(1200);
    uint16_t rbRpm = 0;
    if (readMaxFanValue(rbRpm)) {
      Log.printf("MaxFan Ruecklesen = %u rpm\n", rbRpm);
      if (rbRpm == raw * 10) {
        Log.println("MaxFan wirklich uebernommen");
        setCmdMsg("MaxFan %u rpm uebernommen", rbRpm);
        return true;
      }
    }
    delay(800);
  }
  Log.println("MaxFan NICHT sicher uebernommen");
  setCmdMsg("MaxFan NICHT uebernommen");
  return false;
}

bool setHeatpumpOnOff(bool on) {
  Log.printf("Schreibe WP %s\n", on ? "EIN" : "AUS");
  uint8_t r = writeRegRetry(REG_ONOFF, on ? 1 : 0);
  if (r == node.ku8MBSuccess) {
    Log.println("WP OnOff Schreiben OK");
    for (int i = 0; i < 3; i++) {                      // Ruecklesen, bei Abweichung erneut schreiben
      delay(800);
      if (readWpStateAndMode()) {
        LiveData d = getLive();
        if ((d.wpOnOffRaw != 0) == on) break;
        Log.printf("WP OnOff Ruecklesen: 4096 = %u statt %u -> erneut schreiben\n", d.wpOnOffRaw, on ? 1 : 0);
        writeRegRetry(REG_ONOFF, on ? 1 : 0);
      }
    }
    setCmdMsg("WP %s geschrieben", on ? "EIN" : "AUS");
    return true;
  }
  countErr();
  Log.printf("Fehler WP OnOff schreiben (4096): %u (%s)\n", r, mbErrText(r));
  setCmdMsg("WP schalten FEHLER");
  return false;
}

bool setMode(uint16_t mode) {
  if (!(mode == 1 || mode == 2 || mode == 4)) {
    Log.println("Ungueltiger Modus. Erlaubt: 1=WW, 2=Heizen, 4=Kuehlen");
    return false;
  }
  Log.printf("Schreibe Mode %u %s\n", mode, modeName(mode));
  uint8_t r = writeRegRetry(REG_MODE, mode);
  if (r == node.ku8MBSuccess) {
    Log.println("Mode Schreiben OK");
    delay(500);
    readWpStateAndMode();
    setCmdMsg("Modus %s geschrieben", modeName(mode));
    return true;
  }
  countErr();
  Log.printf("Fehler Mode schreiben (4097): %u (%s)\n", r, mbErrText(r));
  setCmdMsg("Modus schreiben FEHLER");
  return false;
}

// =====================================================
// Befehls-Queue (Web / Touch / Serial -> Modbus-Task)
// =====================================================

QueueHandle_t mbQueue;
SemaphoreHandle_t mbDoneSem;      // nur fuer wartende Aufrufe aus loop()
volatile bool mbDoneResult = false;

bool executeCmd(const MbCmd& c) {
  switch (c.type) {
    case CMD_SET_SOLL:    return setSollwert(c.value);
    case CMD_POWER:       return setHeatpumpOnOff(c.value > 0.5f);
    case CMD_MODE:        return setMode((uint16_t)c.value);
    case CMD_MAXHZ:       return setMaxHz((uint16_t)c.value);
    case CMD_MAXFAN:      return setMaxFan((uint16_t)c.value);
    case CMD_READ_SOLL:   return readSollwert();
    case CMD_READ_MAXHZ:  return readMaxHz();
    case CMD_READ_MAXFAN: return readMaxFan();
    case CMD_READ_FAN:    return readFanRpm();
    case CMD_READ_FLOW:   return readFlow();
    case CMD_READ_PARAMS: return readWpParams();
    case CMD_SET_P06:     return setWpParam(8196, (uint16_t)c.value, "P06 Hysterese Heizen");
    case CMD_SET_P07:     return setWpParam(8197, (uint16_t)c.value, "P07 Hysterese WW");
    case CMD_READ_RAW:    return readRawRegs((uint16_t)c.value, rawReadN);
    case CMD_READ_ALL: {
      bool ok = readWpStateAndMode();
      ok &= readMaxHz(); ok &= readMaxFan(); ok &= readFanRpm();
      ok &= readFlow();  ok &= readSollwert();
      return ok;
    }
  }
  return false;
}

// Aus loop() (Web-Handler): wartet auf Ergebnis inkl. Ruecklesen
bool runCmdBlocking(CmdType t, float v, uint32_t timeoutMs) {
  xSemaphoreTake(mbDoneSem, 0);                    // evtl. alten Zustand loeschen
  MbCmd c{t, v, true, false};
  if (xQueueSend(mbQueue, &c, pdMS_TO_TICKS(2000)) != pdTRUE) return false;
  if (xSemaphoreTake(mbDoneSem, pdMS_TO_TICKS(timeoutMs)) != pdTRUE) return false;
  return mbDoneResult;
}

// Von Touch / Serial: nicht warten
bool submitCmd(CmdType t, float v, bool print) {
  MbCmd c{t, v, false, print};
  return xQueueSend(mbQueue, &c, 0) == pdTRUE;
}

bool valveSlaveActive();      // im Ventil-Teil weiter unten definiert
void processSerialCmd(String cmd);
void valveSlavePoll();

void modbusTask(void*) {
  uint32_t now = millis();
  enum { J_WP, J_TEMPS, J_FLOW, J_HZ, J_FAN, J_SOLL, J_MAXHZ, J_MAXFAN, J_VALVE, J_BLOCK, J_CNT, J_PAR, NJOBS };
  struct Job { uint32_t interval; uint32_t last; void (*fn)(); };
  Job jobs[NJOBS] = {
    {WPSTATE_INTERVAL_MS, 0, []() { readWpStateAndMode(); }},
    {TEMPS_INTERVAL_MS,   0, []() { readTemps(); }},
    {FLOW_INTERVAL_MS,    0, []() { readFlow(); }},
    {HZ_INTERVAL_MS,      0, []() { readHz(); }},
    {FANRPM_INTERVAL_MS,  0, []() { readFanRpm(); }},
    {SOLL_INTERVAL_MS,    0, []() { readSollwert(); }},
    {MAXHZ_INTERVAL_MS,   0, []() { readMaxHz(); }},
    {MAXFAN_INTERVAL_MS,  0, []() { readMaxFan(); }},
    {2000,                0, []() { valveSlavePoll(); }},
    {TEMPS_INTERVAL_MS,   0, []() { readStatusBlock(); }},   // ersetzt Temps/Flow/Hz/Fan
    {30000,               0, []() { readCounterBlock(); }},
    {600000,              0, []() { readWpParams(); }},       // Installateur-Parameter alle 10 min
  };
  for (int i = 0; i < NJOBS; i++) jobs[i].last = now - jobs[i].interval;   // alles gleich zu Beginn

  for (;;) {
    MbCmd c;
    if (xQueueReceive(mbQueue, &c, pdMS_TO_TICKS(20)) == pdTRUE) {
      cmdPrint = c.print;
      bool ok = executeCmd(c);
      cmdPrint = false;
      if (c.wait) { mbDoneResult = ok; xSemaphoreGive(mbDoneSem); }
      continue;     // weitere Befehle zuerst
    }

    // Pro Durchlauf hoechstens EINE Abfrage -> Befehle werden schnell bedient.
    // Faire Auswahl: die am staerksten ueberfaellige Abfrage kommt dran, und
    // "zuletzt" wird erst NACH der Abfrage gesetzt. So kann eine langsame /
    // fehlschlagende Abfrage die anderen nicht mehr verdraengen.
    now = millis();
    int best = -1; float bestRatio = 1.0f;
    for (int i = 0; i < NJOBS; i++) {
      if (i == J_VALVE && !valveSlaveActive()) continue;
      bool single = (i == J_TEMPS || i == J_FLOW || i == J_HZ || i == J_FAN);
      if (single && blockReadOk) continue;           // per Blocklesen abgedeckt
      if (i == J_BLOCK && !blockReadOk) continue;
      float ratio = (float)(now - jobs[i].last) / jobs[i].interval;
      if (ratio >= bestRatio) { bestRatio = ratio; best = i; }
    }
    if (best >= 0) {
      jobs[best].fn();
      jobs[best].last = millis();
    }

    // Lange keine Antwort der WP -> Werte als ungueltig markieren (Anzeige "--")
    if (live.okCount > 0 || mbFailStreak) {
      static uint32_t lastOkMs = 0;
      static uint32_t lastOkCount = 0;
      liveLock();
      if (live.okCount != lastOkCount) { lastOkCount = live.okCount; lastOkMs = millis(); }
      bool stale = millis() - lastOkMs > 60000UL;
      if (stale && (live.tempsValid || live.wpStateValid)) {
        live.tempsValid = live.flowValid = live.hzValid = live.fanRpmValid = false;
        live.sollValid = live.maxHzValid = live.maxFanValid = false;
        live.wpStateValid = live.wpModeValid = false;
        live.extValid = live.cntValid = false;
        live.pEl = live.pTh = 0;
        liveUnlock();
        Log.println("Modbus: seit 60 s keine Antwort der WP -> Werte ungueltig");
      } else liveUnlock();
    }
  }
}

// =====================================================
// ESBE-Ventil + Warmwasser-Ladung (eigener Task "ctrl")
// =====================================================
//
//  Relais 1 (pinPwr): Motor-Versorgung EIN/AUS
//  Relais 2 (pinDir): Richtung. AUS (NC) = Richtung Heizung, AN (NO) = Richtung WW
//  Ventilstellung intern: 0 % = nur Heizung, 100 % = nur WW-Speicher, bufPos = Puffer
//
//  Ablauf jeder Bewegung: Versorgung aus -> Richtung setzen -> 300 ms -> Versorgung an
//  -> Laufzeit -> Versorgung aus -> 300 ms -> Richtungsrelais in Ruhe (aus)
//  Endlagen werden immer mit 10 % Ueberlauf angefahren (Endschalter im Motor),
//  dadurch kalibriert sich die Positionsschaetzung bei jeder Endlagenfahrt neu.

CtrlCfg ctrlCfg;
SemaphoreHandle_t ctrlMutex;

#define RELAY_PINS_TXT "D2..D13, D22..D53"
bool relayPinAllowed(int p) {          // D0/D1 = RS485, D14..D21 = weitere UARTs / I2C
  return p == -1 || (p >= 2 && p <= 13) || (p >= 22 && p <= 53);
}

void ctrlDefaults(CtrlCfg& c) {
  c = CtrlCfg();
  for (int d = 0; d < 7; d++) {
    for (int s = 0; s < SCHED_SLOTS; s++) { c.sched[d][s].min = 0; c.sched[d][s].act = ACT_NONE; }
    c.sched[d][0] = {18 * 60, ACT_WW};       // Beispiel: 18:00 WW laden
    c.sched[d][1] = {21 * 60, ACT_PUFFER};   //           21:00 Speicher als Puffer
  }
}

void loadCtrlCfg() {
  Preferences p;
  p.begin("ctrl", true);
  CtrlCfg tmp;                                   // neue Felder behalten ihre Standardwerte
  size_t len = p.getBytesLength("cfg");
  const size_t oldLen = (offsetof(CtrlCfg, abFixOn) + alignof(CtrlCfg) - 1) / alignof(CtrlCfg) * alignof(CtrlCfg);   // bis v1.33
  bool ok = (len == sizeof(CtrlCfg) || len == offsetof(CtrlCfg, wwMode) || len == oldLen || len == offsetof(CtrlCfg, abFixOn) || len == offsetof(CtrlCfg, abOn) || len == offsetof(CtrlCfg, wwPullMin) || len == offsetof(CtrlCfg, wwNoCont) || len == offsetof(CtrlCfg, drive)) &&
            p.getBytes("cfg", &tmp, len) == len && tmp.version == CTRL_CFG_VERSION;
  p.end();
  if (ok && len < offsetof(CtrlCfg, wwMode)) { CtrlCfg d; tmp.abFixOn = d.abFixOn; tmp.abFixT = d.abFixT; }   // Fuellbytes alter Versionen
  if (ok && len < sizeof(CtrlCfg)) tmp.wwMode = CtrlCfg().wwMode;                                         // bis v1.35
  if (ok) ctrlCfg = tmp; else ctrlDefaults(ctrlCfg);
}

void saveCtrlCfg() {
  CtrlCfg tmp;
  xSemaphoreTake(ctrlMutex, portMAX_DELAY); tmp = ctrlCfg; xSemaphoreGive(ctrlMutex);
  Preferences p;
  p.begin("ctrl", false);
  p.putBytes("cfg", &tmp, sizeof(tmp));
  p.end();
}

CtrlCfg getCtrlCfg() {
  xSemaphoreTake(ctrlMutex, portMAX_DELAY);
  CtrlCfg c = ctrlCfg;
  xSemaphoreGive(ctrlMutex);
  return c;
}

// ---------- Relais ----------
void relayWrite(int8_t pin, bool on) {
  if (pin < 0) return;
  digitalWrite(pin, ctrlCfg.actLow ? !on : on);
}

void relaysInit() {                 // sofort beim Start: beide Relais AUS
  if (ctrlCfg.drive != 0) return;   // Ventilmodul am Modbus -> keine ESP-Relais
  for (int8_t pin : {ctrlCfg.pinPwr, ctrlCfg.pinDir}) {
    if (pin < 0) continue;
    digitalWrite(pin, ctrlCfg.actLow ? HIGH : LOW);   // Pegel vor pinMode setzen -> kein Klacken
    pinMode(pin, OUTPUT);
    digitalWrite(pin, ctrlCfg.actLow ? HIGH : LOW);
  }
}

void dirRelay(bool towardWW) { relayWrite(ctrlCfg.pinDir, ctrlCfg.dirInv ? !towardWW : towardWW); }

// ---------- Ventil-Zustand ----------
enum VPhase : uint8_t { VP_IDLE, VP_DIR, VP_RUN, VP_STOP };

volatile float valvePos = 0;        // geschaetzte Stellung 0..100 %
volatile bool  valveKnown = false;  // Stellung bekannt (nach Endlagenfahrt / gespeichert)
volatile bool  valveMoving = false;
volatile int   valveTarget = -1;    // Ziel der laufenden Fahrt
volatile bool  valveDirWW = false;
static VPhase  vphase = VP_IDLE;
static uint32_t vphaseMs = 0, vRunMs = 0;
static float   vStartPos = 0;
static int     vQueued = -1;        // zweiter Schritt (z. B. erst Endlage, dann Puffer)

volatile int   manualPos = -1;      // -1 = Automatik, sonst 0 / bufPos / 100
volatile int   reqValve = -2;       // Anforderung von Web/Display: -2 nichts, -1 Auto, 0..100
volatile bool  reqWwStart = false, reqWwStop = false;
volatile uint8_t reqWwTarget = 0;      // 0 = WW-Soll aus den Einstellungen
volatile bool  reqWwPv = false;
volatile bool  reqWwManual = false;  // "Warmwasser jetzt" (Display/Web/MQTT): WP immer einschalten, danach Ventil auf Heizung halten
volatile bool  reqValveRef = false;

void saveValveState(bool moving) {
  Preferences p;
  p.begin("valve", false);
  p.putFloat("pos", valvePos);
  p.putBool("known", valveKnown);
  p.putBool("moving", moving);
  p.end();
}

void loadValveState() {
  Preferences p;
  p.begin("valve", true);
  float pos = p.getFloat("pos", 0);
  bool known = p.getBool("known", false);
  bool moving = p.getBool("moving", false);
  p.end();
  valvePos = pos;
  valveKnown = known && !moving;     // Stromausfall waehrend der Fahrt -> unbekannt
  Log.printf("ESBE: gespeicherte Stellung %.0f %% (%s)\n", pos, valveKnown ? "bekannt" : "unbekannt");
}

float valvePosNow() {                // fuer Anzeige, auch waehrend der Fahrt
  if (ctrlCfg.drive == 1 || vphase != VP_RUN) return valvePos;
  uint16_t travel = ctrlCfg.travelSec;
  float delta = (millis() - vphaseMs) / 1000.0f / travel * 100.0f;
  float p = vStartPos + (valveDirWW ? delta : -delta);
  return constrain(p, 0.0f, 100.0f);
}

// startet eine Fahrt zum Ziel (0..100)
void valveBeginMove(int target) {
  CtrlCfg c = getCtrlCfg();
  if (c.drive != 0) return;                           // Ventilmodul faehrt selbst
  if (c.pinPwr < 0 || c.pinDir < 0) return;           // Relais nicht konfiguriert
  bool toEnd = (target <= 0 || target >= 100);
  target = constrain(target, 0, 100);

  if (!toEnd && !valveKnown) {                        // Mittelstellung nur von bekannter Lage aus
    vQueued = target;
    target = 0;
    toEnd = true;
    Log.println("ESBE: Stellung unbekannt -> erst Endlage Heizung anfahren");
  }

  float from = valveKnown ? valvePos : (target == 0 ? 100.0f : 0.0f);
  float dist = fabsf(target - from);
  uint32_t runMs = (uint32_t)(dist / 100.0f * c.travelSec * 1000.0f);
  if (toEnd) runMs += c.travelSec * 100UL;            // +10 % Ueberlauf in den Endschalter
  if (!valveKnown && toEnd) runMs = c.travelSec * 1100UL;

  valveTarget = target;
  valveDirWW = target > from || (target == 100);
  if (target == 0) valveDirWW = false;
  vStartPos = from;
  vRunMs = runMs;
  relayWrite(c.pinPwr, false);
  dirRelay(valveDirWW);
  vphase = VP_DIR;
  vphaseMs = millis();
  valveMoving = true;
  saveValveState(true);
  Log.printf("ESBE: fahre %s -> %d %% (%.0f s)\n", valveDirWW ? "Richtung WW" : "Richtung Heizung",
             target, runMs / 1000.0f);
}

void valveTick() {
  uint32_t ms = millis();
  switch (vphase) {
    case VP_IDLE: break;
    case VP_DIR:
      if (ms - vphaseMs >= 300) {
        relayWrite(ctrlCfg.pinPwr, true);
        vphase = VP_RUN; vphaseMs = ms;
      }
      break;
    case VP_RUN:
      if (ms - vphaseMs >= vRunMs) {
        relayWrite(ctrlCfg.pinPwr, false);
        vphase = VP_STOP; vphaseMs = ms;
      }
      break;
    case VP_STOP:
      if (ms - vphaseMs >= 300) {
        dirRelay(false);                              // Richtungsrelais in Ruhe
        valvePos = valveTarget;
        valveKnown = true;
        valveMoving = false;
        vphase = VP_IDLE;
        saveValveState(false);
        Log.printf("ESBE: Stellung %d %% erreicht\n", valveTarget);
        if (vQueued >= 0) { int q = vQueued; vQueued = -1; valveBeginMove(q); }
      }
      break;
  }
}

// ---------- Ventilmodul am Modbus (Arduino, Slave 2) ----------
extern volatile uint8_t wwState;          // weiter unten (Warmwasser-Teil)
ModbusMaster nodeV;
volatile bool     slaveOnline = false;
volatile bool     valveFailsafe = false;
volatile uint32_t slaveOkCount = 0, slaveErrCount = 0, slaveRetry = 0;
volatile int      slaveTarget = -1;       // vom ctrl-Task gesetzt
volatile bool     slaveRefReq = false;
static uint32_t   slaveLastOkMs = 0;
static uint16_t   slaveHb = 0;

bool valveSlaveActive() { return ctrlCfg.drive == 1 && ctrlCfg.wwMode == 0; }

void valveSlaveSetup() {
  nodeV.begin(ctrlCfg.slaveId, Serial1);
  nodeV.preTransmission(preTransmission);
  nodeV.postTransmission([]() { postTxDiscard(ctrlCfg.slaveId); });
  nodeV.idle([]() { vTaskDelay(1); });
}

// laeuft im Modbus-Task (alle 2 s)
void valveSlavePoll() {
  CtrlCfg c = getCtrlCfg();
  LiveData d = getLive();
  bool wwAct = (wwState == WW_MOVE || wwState == WW_HEAT || wwState == WW_COOL);
  auto t10 = [&](float v) -> uint16_t {
    return d.tempsValid ? (uint16_t)(int16_t)lroundf(v * 10.0f) : (uint16_t)0x8000;
  };

  // 1) Laufzeit, Notfall, Lebenszeichen, Temperaturen, Flags -> Reg 4..12
  nodeV.clearTransmitBuffer();
  nodeV.setTransmitBuffer(0, c.travelSec);
  nodeV.setTransmitBuffer(1, c.fsMin);
  nodeV.setTransmitBuffer(2, 0);                         // Notfall-Stellung = Heizung
  nodeV.setTransmitBuffer(3, ++slaveHb);
  nodeV.setTransmitBuffer(4, t10(d.vorlauf));
  nodeV.setTransmitBuffer(5, t10(d.ruecklauf));
  nodeV.setTransmitBuffer(6, t10(d.warmwasser));
  nodeV.setTransmitBuffer(7, (d.wpStateValid && d.wpOnOffRaw ? 1 : 0) | (wwAct ? 2 : 0));
  nodeV.setTransmitBuffer(8, c.wwSoll);
  clearSerial1Buffer();
  uint8_t r = nodeV.writeMultipleRegisters(4, 9);
  if (r != nodeV.ku8MBSuccess) { slaveRetry++; delay(20); clearSerial1Buffer(); r = nodeV.writeMultipleRegisters(4, 9); }
  bool ok = (r == nodeV.ku8MBSuccess);

  // 2) Soll-Stellung -> Reg 0
  int t = slaveTarget;
  if (ok && t >= 0 && c.enabled) {
    clearSerial1Buffer();
    r = nodeV.writeSingleRegister(0, (uint16_t)t);
    if (r != nodeV.ku8MBSuccess) { slaveRetry++; delay(20); clearSerial1Buffer(); r = nodeV.writeSingleRegister(0, (uint16_t)t); }
    ok = (r == nodeV.ku8MBSuccess);
  }
  // 3) Referenzfahrt -> Reg 1
  if (ok && slaveRefReq) {
    clearSerial1Buffer();
    r = nodeV.writeSingleRegister(1, 1);
    ok = (r == nodeV.ku8MBSuccess);
    if (ok) { slaveRefReq = false; Log.println("Ventilmodul: Referenzfahrt gesendet"); }
  }
  // 4) Rueckmeldung <- Reg 2..3
  if (ok) {
    clearSerial1Buffer();
    r = nodeV.readHoldingRegisters(2, 2);
    if (r != nodeV.ku8MBSuccess) { slaveRetry++; delay(20); clearSerial1Buffer(); r = nodeV.readHoldingRegisters(2, 2); }
    ok = (r == nodeV.ku8MBSuccess);
    if (ok) {
      uint16_t st = nodeV.getResponseBuffer(1);
      valvePos      = nodeV.getResponseBuffer(0) / 10.0f;
      valveMoving   = (st & 0x03) != 0;
      valveDirWW    = (st & 0x01) != 0;
      valveKnown    = (st & 0x10) == 0;
      valveFailsafe = (st & 0x20) != 0;
    }
  }

  if (ok) {
    if (!slaveOnline) Log.printf("Ventilmodul (ID %u) online\n", c.slaveId);
    slaveOnline = true;
    slaveLastOkMs = millis();
    slaveOkCount++;
  } else {
    slaveErrCount++;
    if (slaveErrCount % 30 == 1 || verbose)
      Log.printf("Ventilmodul (ID %u): Fehler %u (%s)\n", c.slaveId, r, mbErrText(r));
    if (slaveOnline && millis() - slaveLastOkMs > 15000) {
      slaveOnline = false;
      valveKnown = false;
      valveMoving = false;
      Log.println("Ventilmodul: keine Verbindung");
    }
  }
}

// ---------- Zeitplan ----------
static const char* WDAY_NAME[7] = {"Mo", "Di", "Mi", "Do", "Fr", "Sa", "So"};

const char* actName(uint8_t a) {
  switch (a) {
    case ACT_WW:     return "WW laden";
    case ACT_PUFFER: return "Puffer";
    case ACT_HEIZ:   return "Heizung";
    default:         return "-";
  }
}

int actToPos(uint8_t a, const CtrlCfg& c) {
  if (a == ACT_PUFFER) return c.bufPos;
  return 0;                                           // WW laden -> danach Heizung, Heizung -> 0
}

// Stellung laut Zeitplan = letztes vergangenes Ereignis
int scheduledBase(const CtrlCfg& c, uint8_t* actOut) {
  if (actOut) *actOut = ACT_NONE;
  if (!timeValid()) return actToPos(c.defAct, c);
  time_t tt = time(nullptr); struct tm tmv; localtime_r(&tt, &tmv);
  int today = (tmv.tm_wday + 6) % 7;                  // 0 = Montag
  int nowMin = tmv.tm_hour * 60 + tmv.tm_min;
  for (int back = 0; back <= 7; back++) {
    int d = (today - back + 7) % 7;
    int limit = back == 0 ? nowMin : 1439;
    int best = -1; uint8_t act = ACT_NONE;
    for (int s = 0; s < SCHED_SLOTS; s++) {
      const SchedEv& e = c.sched[d][s];
      if (e.act != ACT_NONE && e.min <= limit && (int)e.min > best) { best = e.min; act = e.act; }
    }
    if (best >= 0) { if (actOut) *actOut = act; return actToPos(act, c); }
  }
  return actToPos(c.defAct, c);
}

void nextEventText(const CtrlCfg& c, char* out, size_t n) {
  strlcpy(out, "-", n);
  if (!timeValid()) return;
  time_t tt = time(nullptr); struct tm tmv; localtime_r(&tt, &tmv);
  int today = (tmv.tm_wday + 6) % 7;
  int nowMin = tmv.tm_hour * 60 + tmv.tm_min;
  for (int fwd = 0; fwd <= 7; fwd++) {
    int d = (today + fwd) % 7;
    int best = 2000; uint8_t act = ACT_NONE;
    for (int s = 0; s < SCHED_SLOTS; s++) {
      const SchedEv& e = c.sched[d][s];
      if (e.act == ACT_NONE) continue;
      if (fwd == 0 && (int)e.min <= nowMin) continue;
      if (e.min < best) { best = e.min; act = e.act; }
    }
    if (act != ACT_NONE) {
      snprintf(out, n, "%s %02d:%02d %s", WDAY_NAME[d], best / 60, best % 60, actName(act));
      return;
    }
  }
}

// ---------- Warmwasser-Ladung ----------
volatile uint8_t wwState = WW_IDLE;
static uint32_t wwBeginMs = 0, wwStateMs = 0, wwCheckMs = 0, wwBackArrMs = 0;
static bool     wwManual = false;      // laufende Ladung kam von "Warmwasser jetzt"
static bool     wwSawOn = false;       // WP war waehrend der Ladung schon einmal an
static uint8_t  wwPowerTries = 0, wwModeTries = 0;
static uint32_t wwGuardMs = 0;
static float    wwSavedSoll = 0;
static int      wwSollNow = 0;         // waehrend der Ladung zuletzt geschriebener VL-Soll
static uint32_t wwRaiseMs = 0;         // letzte Anhebung des VL-Solls
static bool     wwSavedOn = true;
static uint16_t wwSavedMode = 2;
static bool     wwRecover = false;
static bool     wwHzSeen = false;      // WW-Modus der WP: Verdichter lief in dieser Ladung schon
static uint32_t wwHzOffMs = 0;         // ... und steht seit
char wwInfo[48] = "";

const char* wwStateName(uint8_t s) {
  switch (s) {
    case WW_IDLE: return "aus";
    case WW_MOVE: return "Ventil faehrt auf WW";
    case WW_HEAT: return "laedt";
    case WW_COOL: return "Nachlauf";
    case WW_BACK: return "zurueck auf Heizung";
    default:      return "?";
  }
}

void saveWwRun(bool active) {
  Preferences p;
  p.begin("wwrun", false);
  p.putBool("active", active);
  p.putFloat("soll", wwSavedSoll);
  p.putBool("on", wwSavedOn);
  p.putUShort("mode", wwSavedMode);
  p.end();
}

void loadWwRun() {                   // Neustart mitten in einer Ladung -> alte Werte wiederherstellen
  Preferences p;
  p.begin("wwrun", true);
  bool active = p.getBool("active", false);
  wwSavedSoll = p.getFloat("soll", 0);
  wwSavedOn = p.getBool("on", true);
  wwSavedMode = p.getUShort("mode", 2);
  p.end();
  if (active) {
    wwRecover = true;
    Log.printf("WW: Neustart waehrend Ladung -> stelle Sollwert %.0f wieder her\n", wwSavedSoll);
  }
}

void powerCmd(bool on, const char* src);     // weiter unten (Frequenz-Teil)

volatile int8_t hcWant = -1;           // Auto-WP: aktueller Heizbedarf (-1 unbekannt / Auto aus, 0 aus, 1 an)
LockCfg lockCfg;
volatile bool lockOn = false;          // Sperrzeit wirkt gerade (WP soll aus sein)
volatile bool nightOffOn = false;      // Nacht-Aus wirkt gerade (Nachtzeit und aussen warm genug)
volatile bool lockWin = false;         // Zeitfenster laeuft (auch wenn wegen Kaelte aufgehoben)
char lockInfo[64] = "aus";
extern HcCfg hcCfg;                    // weiter unten (Heizregelung)
extern volatile int sgState;

void wwRestorePump() {               // Sollwert / EIN-AUS / Modus wie vor der Ladung
  bool wpMode = ctrlCfg.wwMode == 1;
  if (wpMode) {                      // WW-Modus der WP: nur den Modus zurueck, den Sollwert nicht anfassen
    uint16_t m = (wwSavedMode == 2 || wwSavedMode == 4) ? wwSavedMode : 2;
    submitCmd(CMD_MODE, m, false);
  } else submitCmd(CMD_SET_SOLL, wwSavedSoll, false);
  if (!wwSavedOn) {
    if (hcCfg.autoEnable && hcWant == 1 && sgState != 1)
      Log.println("WW: Ende der Ladung - WP bleibt an (Auto-WP: Heizbedarf)");
    else powerCmd(false, "Ende WW-Ladung (WP war vorher aus)");
  }
  if (!wpMode && wwSavedMode != 2 && (wwSavedMode == 1 || wwSavedMode == 4)) submitCmd(CMD_MODE, wwSavedMode, false);
}

static uint8_t wwTarget = 50;          // Ziel der laufenden Ladung (normal oder PV)
volatile int   sgState = 2;            // SG-Ready 1..4 (2 = normal)
volatile bool  pvLoad = false;         // laufende Ladung kommt von SG3/4

// Verdichter am Laufen halten: liegt der VL knapp unter dem VL-Soll, Soll anheben.
// Die WP schaltet den Verdichter ab, sobald der VL ueber dem Soll liegt - bei der WW-Ladung
// passierte das kurz vor dem Ziel (Speicher noch nicht warm, VL schon am Soll).
// Rueckgabe: neuer Soll oder 0 (nichts geschrieben)
int wwKeepRunning(const LiveData& d, int cap, const char* what) {
  if (!d.tempsValid || !d.hzValid || !d.wpStateValid || !d.wpOnOffRaw || d.verdichterHz <= 0) return 0;
  if (wwSollNow >= cap || d.vorlauf < wwSollNow - 1.5f) return 0;
  if (wwRaiseMs && millis() - wwRaiseMs < 30000UL) return 0;
  int ns = min(cap, (int)lroundf(d.vorlauf) + 3);
  if (ns <= wwSollNow) return 0;
  Log.printf("WW: VL %.1f C knapp am Soll %d C -> %s %d C (Verdichter laeuft weiter)\n", d.vorlauf, wwSollNow, what, ns);
  submitCmd(CMD_SET_SOLL, ns, false);
  wwSollNow = ns;
  wwRaiseMs = millis();
  return ns;
}

void wwBegin(const char* why, uint8_t target, bool manual) {
  CtrlCfg c = getCtrlCfg();
  LiveData d = getLive();
  if (target < 30 || target > 70) target = c.wwSoll;
  if (sgState == 1) {
    Log.println("WW: SG1 (Sperre) aktiv -> keine Ladung");
    setCmdMsg("WW: SG-Sperre aktiv");
    return;
  }
  if (!d.tempsValid || !d.sollValid || !d.wpStateValid) {
    Log.println("WW: keine Modbus-Daten -> Ladung nicht moeglich");
    setCmdMsg("WW: keine Modbus-Daten");
    return;
  }
  if (d.warmwasser >= target) {
    Log.printf("WW: %.1f C >= Soll %u C -> keine Ladung noetig\n", d.warmwasser, target);
    setCmdMsg("WW hat schon %.0f C (Soll %u)", d.warmwasser, target);
    return;
  }
  if (c.wwMode == 0 && c.drive == 1 && !slaveOnline) {
    Log.println("WW: Ventilmodul nicht erreichbar");
    setCmdMsg("WW: Ventilmodul fehlt");
    return;
  }
  if (c.wwMode == 0 && c.drive == 0 && (c.pinPwr < 0 || c.pinDir < 0)) {
    Log.println("WW: Relais-Pins nicht konfiguriert");
    setCmdMsg("WW: Relais fehlen");
    return;
  }
  if (!d.wpOnOffRaw && !c.wpOnForWw && !manual) {
    Log.println("WW: WP ist aus -> Ladung uebersprungen");
    return;
  }
  wwSavedSoll = d.sollwert;
  wwSavedOn = d.wpOnOffRaw;
  wwSavedMode = d.wpModeRaw;
  saveWwRun(true);
  // Reihenfolge: Modus, dann EIN. Ventil am ESP: Speicher wird im Heizbetrieb ueber das Ventil geladen.
  // WW-Modus der WP: die WP schaltet ihr eigenes Ventil und heizt bis zu ihrem WW-Soll.
  uint16_t wantMode = c.wwMode == 1 ? 1 : 2;
  if (d.wpModeValid && d.wpModeRaw != wantMode) submitCmd(CMD_MODE, wantMode, false);
  if (!d.wpOnOffRaw) powerCmd(true, "WW-Ladung");
  wwManual = manual;
  wwSawOn = d.wpOnOffRaw;
  wwGuardMs = millis();
  wwPowerTries = d.wpOnOffRaw ? 0 : 1;
  wwModeTries = (d.wpModeValid && d.wpModeRaw != wantMode) ? 1 : 0;
  wwHzSeen = false; wwHzOffMs = 0;
  if (manual) manualPos = -1;                  // evtl. Handstellung aufheben, Ventil faehrt auf WW
  wwTarget = target;
  wwState = c.wwMode == 1 ? WW_HEAT : WW_MOVE;
  wwBeginMs = wwStateMs = wwCheckMs = millis();
  Log.printf("WW: Ladung gestartet (%s%s), Ist %.1f C, Ziel %u C, Heiz-Soll gemerkt %.0f C\n",
             why, c.wwMode == 1 ? ", WW-Modus der WP" : "", d.warmwasser, target, wwSavedSoll);
  // laeuft der Verdichter gerade (Heizen), waehrend der Ventilfahrt nicht am Heiz-Soll abschalten lassen
  wwSollNow = lroundf(d.sollwert); wwRaiseMs = 0;
  if (c.wwMode == 0) wwKeepRunning(d, min(75, target + c.boost), "Halte-Soll waehrend Ventilfahrt");
  setCmdMsg("WW-Ladung gestartet");
}

// nach "Warmwasser jetzt": Ventil auf Heizung und dort bis zum naechsten Zeitplan-Ereignis lassen
void wwManualDone() {
  if (!wwManual) return;
  wwManual = false;
  CtrlCfg c = getCtrlCfg();
  if (c.abOn || c.abLow || c.abFixOn) {                       // Puffer-Automatik an: die entscheidet ab jetzt
    manualPos = -1;
    Log.println("WW: Ventil wieder in Automatik (Puffer-Automatik)");
    return;
  }
  manualPos = 0;
  Log.println("WW: Ventil auf Heizung (bleibt bis zum naechsten Zeitplan-Ereignis)");
}

// Ziel erreicht, Verdichter laeuft und es soll weitergeheizt werden: Ventil sofort auf Heizung,
// VL-Soll erst auf den Heizwert setzen, wenn das kalte Heizungswasser angekommen ist.
// So bleibt der Verdichter an (beim sofortigen Umstellen lag der VL weit ueber dem neuen
// Soll -> WP stoppte und lief erst nach ihrer Sperrzeit wieder an).
void wwBackStart(const char* reason) {
  Log.printf("WW: Ladung beendet (%s) -> Ventil direkt auf Heizung, Verdichter laeuft weiter\n", reason);
  setCmdMsg("WW: %s, weiter mit Heizen", reason);
  wwManualDone();                                // "Warmwasser jetzt": Ventil bleibt danach auf Heizung
  wwState = WW_BACK; wwStateMs = millis(); wwBackArrMs = 0;
}

void wwFinish(const char* reason) {
  Log.printf("WW: Ladung beendet (%s)\n", reason);
  setCmdMsg("WW: %s", reason);
  wwRestorePump();
  CtrlCfg c = getCtrlCfg();
  if (wwState == WW_HEAT && c.coolSec > 0 && c.wwMode == 0) { wwState = WW_COOL; wwStateMs = millis(); }
  else { wwState = WW_IDLE; saveWwRun(false); wwManualDone(); }
}

// WW-Modus der WP: die WP laedt selbst. Fertig, wenn das WW das Ziel erreicht oder die WP den Verdichter
// im WW-Modus 3 min lang abschaltet (dann hat sie ihren eigenen WW-Soll erreicht).
void wwHeatWp(const CtrlCfg& c, const LiveData& d, uint32_t ms) {
  if (ms - wwCheckMs > 60000) {
    wwCheckMs = ms;
    if (d.wpStateValid && !d.wpOnOffRaw && wwSawOn && ms - wwStateMs > 120000) {
      wwSavedOn = false;                         // wurde extern ausgeschaltet -> aus lassen
      wwFinish("WP wurde ausgeschaltet");
      return;
    }
  }
  bool modeOk = d.wpModeValid && d.wpModeRaw == 1;
  if (modeOk && d.hzValid && d.verdichterHz > 0) { wwHzSeen = true; wwHzOffMs = 0; }
  else if (modeOk && d.hzValid && wwHzSeen && !wwHzOffMs) wwHzOffMs = ms;
  if (d.tempsValid && d.warmwasser >= wwTarget) {
    char r[40]; snprintf(r, sizeof(r), "Ziel erreicht (%.1f C)", d.warmwasser);
    wwFinish(r);
  } else if (wwHzOffMs && ms - wwHzOffMs > 180000UL) {
    char r[48]; snprintf(r, sizeof(r), "WP fertig (Verdichter aus, WW %.1f C)", d.warmwasser);
    wwFinish(r);
  }
}

void wwTick() {
  uint32_t ms = millis();
  CtrlCfg c = getCtrlCfg();
  LiveData d = getLive();

  if (wwRecover && d.sollValid) {              // nach Neustart: Pumpe zuruecksetzen
    wwRecover = false;
    wwRestorePump();
    saveWwRun(false);
  }

  if (reqWwStop) {
    reqWwStop = false;
    if (wwState == WW_MOVE || wwState == WW_HEAT) wwFinish("abgebrochen");
    else if (wwState == WW_COOL) { wwState = WW_IDLE; saveWwRun(false); }
    else if (wwState == WW_BACK) { wwRestorePump(); wwState = WW_IDLE; saveWwRun(false); }
  }
  if (reqWwStart) {
    reqWwStart = false;
    uint8_t t = reqWwTarget; reqWwTarget = 0;
    bool pv = reqWwPv; reqWwPv = false;
    bool man = reqWwManual; reqWwManual = false;
    if (man && wwState == WW_COOL) { wwState = WW_IDLE; saveWwRun(false); }   // Nachlauf abbrechen, neu laden
    if (!man && lockOn && !lockCfg.wwAllow) {
      static uint32_t lastLockLog = 0;
      if (!lastLockLog || millis() - lastLockLog > 600000UL) {
        lastLockLog = millis();
        Log.printf("WW: Sperrzeit (%s) -> %s-Ladung uebersprungen\n", lockInfo, pv ? "PV" : "Zeitplan");
      }
    } else if (wwState == WW_IDLE) {
      wwBegin(pv ? "PV-Ueberschuss (SG)" : man ? "Warmwasser jetzt" : "Zeitplan", t, man && !pv);
      pvLoad = pv && (wwState != WW_IDLE);
    } else if (man) setCmdMsg("WW-Ladung laeuft bereits");
    // WICHTIG: wwBegin() setzt die Startzeiten mit millis() -> "ms" ist jetzt aelter.
    // Ohne Neu-Lesen ergibt "ms - wwBeginMs" einen Unterlauf (riesige Zahl)
    // und die Ladung wurde sofort mit "Zeitlimit erreicht" beendet.
    ms = millis();
    d = getLive();
  }

  // WP einschalten / Modus Heizen absichern (falls ein Schreibbefehl nicht durchkam)
  if ((wwState == WW_MOVE || wwState == WW_HEAT) && d.wpStateValid && ms - wwGuardMs > 30000) {
    wwGuardMs = ms;
    if (d.wpOnOffRaw) wwSawOn = true;
    else if (!wwSawOn) {
      if (wwPowerTries >= 5) { wwFinish("WP laesst sich nicht einschalten"); return; }
      wwPowerTries++;
      Log.printf("WW: WP noch aus -> EIN erneut senden (%u/5)\n", wwPowerTries);
      powerCmd(true, "WW-Ladung (erneut)");
    }
    uint16_t wm = c.wwMode == 1 ? 1 : 2;
    if (d.wpModeValid && d.wpModeRaw != wm && wwModeTries < 5) {
      wwModeTries++;
      Log.printf("WW: Modus %s -> %s erneut senden (%u/5)\n", modeName(d.wpModeRaw), modeName(wm), wwModeTries);
      submitCmd(CMD_MODE, wm, false);
    }
    if (wwState == WW_MOVE) {
      Log.printf("WW: warte auf Ventil (%.0f %%%s)\n", (float)valvePos,
                 !valveKnown ? ", Stellung unbekannt - Referenzfahrt?" : valveMoving ? ", faehrt" : "");
    }
  }

  if ((wwState == WW_MOVE || wwState == WW_HEAT) && ms - wwBeginMs > c.maxMin * 60000UL) {
    wwFinish("Zeitlimit erreicht");
    return;
  }

  if (wwState == WW_MOVE && ms - wwStateMs > (c.travelSec * 2UL + 60UL) * 1000UL) {
    wwFinish("Ventil erreicht WW-Stellung nicht");
    return;
  }

  switch (wwState) {
    case WW_MOVE:
      if (!valveMoving && valveKnown && valvePos >= 99) {
        int soll = max(min(75, wwTarget + c.boost), wwSollNow);
        submitCmd(CMD_SET_SOLL, soll, false);
        wwSollNow = soll; wwRaiseMs = 0;
        Log.printf("WW: Ventil auf WW, VL-Soll -> %d C\n", soll);
        wwState = WW_HEAT; wwStateMs = wwCheckMs = ms;
      } else wwKeepRunning(d, min(75, wwTarget + c.boost), "Halte-Soll waehrend Ventilfahrt");
      break;
    case WW_HEAT: {
      if (c.wwMode == 1) { wwHeatWp(c, d, ms); break; }
      int base = min(75, wwTarget + c.boost);
      int cap = max(base, min(75, (int)c.wwVlMax));          // bis hierhin darf der VL-Soll mitwandern
      if (wwKeepRunning(d, cap, "VL-Soll angehoben auf")) wwCheckMs = ms;
      if (ms - wwCheckMs > 60000) {
        wwCheckMs = ms;
        if (d.sollValid && lroundf(d.sollwert) != wwSollNow) submitCmd(CMD_SET_SOLL, wwSollNow, false);
        if (d.wpStateValid && !d.wpOnOffRaw && wwSawOn && ms - wwStateMs > 120000) {
          wwSavedOn = false;                       // wurde extern ausgeschaltet -> aus lassen
          wwFinish("WP wurde ausgeschaltet");
          break;
        }
      }
      // Grenze erreicht und VL steht trotzdem am Soll: knapp unter dem Ziel beenden,
      // bevor der Verdichter abschaltet (dann kann direkt weitergeheizt werden)
      bool atCap = d.tempsValid && wwSollNow >= cap && d.vorlauf >= cap - 1.0f && d.warmwasser >= wwTarget - 2.0f;
      if (d.tempsValid && (d.warmwasser >= wwTarget || atCap)) {
        char r[40]; snprintf(r, sizeof(r), "%s (%.1f C)", d.warmwasser >= wwTarget ? "Ziel erreicht" : "fast erreicht, VL-Grenze", d.warmwasser);
        bool runs = d.wpStateValid && d.wpOnOffRaw && d.hzValid && d.verdichterHz > 0;
        bool heatWanted = hcCfg.autoEnable ? (hcWant == 1 && !lockOn) : wwSavedOn;   // danach soll geheizt werden
        if (!c.wwNoCont && runs && heatWanted && sgState != 1) wwBackStart(r);
        else wwFinish(r);
      }
      break;
    }
    case WW_BACK: {
      // warten, bis das Ventil weg von WW ist und das kalte Heizungswasser den VL abgekuehlt hat
      bool arrived = !valveMoving && valveKnown && valvePos < 99;
      if (arrived && !wwBackArrMs) wwBackArrMs = ms;
      float heatSoll = wwSavedSoll;
      bool cooled = d.tempsValid && d.vorlauf <= heatSoll + 1.0f;
      bool stopped = d.wpStateValid && (!d.wpOnOffRaw || (d.hzValid && d.verdichterHz == 0 && ms - wwStateMs > 60000));
      if ((wwBackArrMs && (cooled || ms - wwBackArrMs > 180000UL)) || stopped ||
          ms - wwStateMs > (c.travelSec + 300UL) * 1000UL) {
        wwRestorePump();                             // Heiz-Sollwert (und Modus) wie vor der Ladung
        wwState = WW_IDLE;
        saveWwRun(false);
        Log.printf("WW: zurueck auf Heizung, VL-Soll -> %.0f C (VL %.1f C)%s\n", heatSoll, d.vorlauf,
                   stopped ? ", Verdichter stand schon" : "");
      }
      break;
    }
    case WW_COOL:
      if (ms - wwStateMs > c.coolSec * 1000UL) {
        wwState = WW_IDLE;
        saveWwRun(false);
        if (wwManual) wwManualDone();
        else Log.println("WW: Nachlauf beendet -> Ventil nach Zeitplan");
      }
      break;
    default: break;
  }

  if (wwState == WW_IDLE) { wwInfo[0] = 0; pvLoad = false; }
  else snprintf(wwInfo, sizeof(wwInfo), "%s%s, WW %.1f/%u C", pvLoad ? "PV: " : "",
                wwStateName(wwState), d.warmwasser, wwTarget);
}

// ---------- WW-Ladung vorziehen ----------
// Heizt die WP gerade und steht der VL am Soll (Verdichter schaltet gleich ab), und steht in den
// naechsten wwPullMin Minuten eine WW-Ladung im Zeitplan: jetzt laden. Der Verdichter laeuft so
// durch, statt kurz vor der Ladung fuer wenige Minuten zu stoppen. Das Plan-Ereignis entfaellt dann.
static const uint32_t KEY_NONE = 0xFFFFFFFF;
static uint32_t wwPulledKey = KEY_NONE, wwPullTryKey = KEY_NONE;
static uint32_t wwPulledMs = 0, wwPullTryMs = 0, wwPullTickMs = 0;

void wwPullTick() {
  uint32_t ms = millis();
  if (ms - wwPullTickMs < 5000UL) return;
  wwPullTickMs = ms;
  if (wwPulledKey != KEY_NONE && ms - wwPulledMs > 3UL * 3600000UL) wwPulledKey = KEY_NONE;   // Sicherheit
  if (wwPullTryKey != KEY_NONE && ms - wwPullTryMs > 3UL * 3600000UL) wwPullTryKey = KEY_NONE;
  CtrlCfg c = getCtrlCfg();
  if (!c.wwPullMin || wwState != WW_IDLE || !timeValid()) return;
  if (sgState == 1 || (lockOn && !lockCfg.wwAllow)) return;
  LiveData d = getLive();
  if (!d.tempsValid || !d.sollValid || !d.wpStateValid || !d.hzValid) return;
  if (!d.wpOnOffRaw || d.verdichterHz <= 0) return;           // nur bei laufendem Verdichter
  if (d.wpModeValid && d.wpModeRaw != 2) return;               // nur im Heizbetrieb
  if (d.vorlauf < d.sollwert - 0.5f) return;                   // VL noch nicht am Soll -> laeuft noch
  if (d.warmwasser >= c.wwSoll) return;                        // Speicher ist noch warm genug
  time_t tt = time(nullptr); struct tm tmv; localtime_r(&tt, &tmv);
  int today = (tmv.tm_wday + 6) % 7, nowMin = tmv.tm_hour * 60 + tmv.tm_min;
  for (int fwd = 0; fwd <= 1; fwd++) {
    int day = (today + fwd) % 7;
    for (int s = 0; s < SCHED_SLOTS; s++) {
      const SchedEv& e = c.sched[day][s];
      if (e.act != ACT_WW) continue;
      int delta = fwd * 1440 + (int)e.min - nowMin;
      if (delta < 1 || delta > c.wwPullMin) continue;
      uint32_t key = day * 1440 + e.min;
      if (key == wwPullTryKey || key == wwPulledKey) return;  // fuer dieses Ereignis schon versucht
      wwPullTryKey = key; wwPullTryMs = ms;
      char why[40]; snprintf(why, sizeof(why), "vorgezogen von %02d:%02d", e.min / 60, e.min % 60);
      Log.printf("WW: VL %.1f am Soll %.0f, Verdichter wuerde stoppen -> Ladung von %02d:%02d jetzt (%d min frueher)\n",
                 d.vorlauf, d.sollwert, e.min / 60, e.min % 60, delta);
      wwBegin(why, c.wwSoll, false);
      if (wwState != WW_IDLE) { wwPulledKey = key; wwPulledMs = millis(); }
      return;
    }
  }
}

// ---------- gewuenschte Ventilstellung ----------
// ---------- Puffer-Automatik ----------
// Statt nach der WW-Ladung nur nach Uhrzeit auf Puffer zu gehen: Ventil bleibt auf Heizung, bis das
// WW nur noch wenig waermer ist als der Heiz-VL-Soll (bzw. darunter liegt). Dann bleibt es bis zur
// naechsten WW-Ladung auf Puffer (Merker, ueberlebt auch einen Neustart).
// Plan-Eintraege bleiben fest: "Puffer" (z. B. 02:00) = auf jeden Fall Puffer, "Heizung" = Heizung.
// WP aus / nicht im Heizbetrieb = Heizung (Merker bleibt, danach wieder Puffer).
extern volatile int hcTarget;
static int8_t abLatched = -1;                                   // -1 = noch nicht geladen
char abInfo[72] = "";
static void abInfoSet(const char* fmt, ...) {
  va_list ap; va_start(ap, fmt); vsnprintf(abInfo, sizeof(abInfo), fmt, ap); va_end(ap);
}
static void abLatch(bool on) {
  if (abLatched == (on ? 1 : 0)) return;
  abLatched = on ? 1 : 0;
  Preferences p; p.begin("ab", false); p.putBool("on", on); p.end();
}
float abHeatSoll(const LiveData& d) {                           // aktueller Heiz-VL-Soll
  if (hcCfg.enabled && hcTarget >= 0) return hcTarget;
  return d.sollValid ? d.sollwert : NAN;
}

int valveDesired(const CtrlCfg& c, const LiveData& d) {
  if (abLatched < 0) { Preferences p; p.begin("ab", true); abLatched = p.getBool("on", false) ? 1 : 0; p.end(); }
  if (wwState == WW_MOVE || wwState == WW_HEAT || wwState == WW_COOL) {   // neue Ladung -> Merker loeschen
    if (abLatched == 1) { abLatch(false); Log.println("Puffer-Automatik: WW-Ladung -> zurueck auf Heizung bis zur naechsten Schwelle"); }
    strlcpy(abInfo, "WW-Ladung", sizeof(abInfo));
    return 100;
  }
  bool autoOn = c.abOn || c.abLow || c.abFixOn;
  if (manualPos >= 0) {                                         // Handbetrieb (bis zum naechsten Ereignis)
    if (autoOn) strlcpy(abInfo, "pausiert: Ventil von Hand (Taste Automatik oder naechstes Ereignis)", sizeof(abInfo));
    return manualPos;
  }
  if (d.wpStateValid && !d.wpOnOffRaw) {                        // WP aus -> Heizung (WW-Speicher abkoppeln)
    if (autoOn) abInfoSet(abLatched == 1 ? "Heizung (WP aus), danach wieder Puffer" : "Heizung (WP aus)");
    return 0;
  }
  uint8_t act = ACT_NONE;
  int base = scheduledBase(c, &act);
  if (!autoOn) { abInfo[0] = 0; return base; }
  if (base != 0 || act == ACT_HEIZ) {                           // fester Plan-Eintrag gilt
    abInfoSet(base ? "Puffer laut Zeitplan" : "Heizung laut Zeitplan");
    return base;
  }
  // nach "WW laden" (oder ohne Plan-Eintrag): Automatik, nur bei laufender Heizung
  bool heating = d.wpStateValid && d.wpOnOffRaw && (!d.wpModeValid || d.wpModeRaw == 2) && wwState == WW_IDLE;
  if (!heating) {
    abInfoSet(wwState == WW_BACK ? "Heizung (WW-Ladung gerade fertig)" : abLatched == 1 ? "Heizung (kein Heizbetrieb), danach wieder Puffer" : "Heizung (kein Heizbetrieb)");
    return 0;
  }
  if (abLatched == 1) { if (!strstr(abInfo, "bis zur")) abInfoSet("Puffer bis zur naechsten WW-Ladung"); return c.bufPos; }
  float vs = abHeatSoll(d);
  bool relOn = c.abOn || c.abLow;
  if (!d.tempsValid || (!c.abFixOn && isnan(vs))) { abInfoSet("Heizung (keine Messwerte)"); return 0; }
  float diff = isnan(vs) ? NAN : d.warmwasser - vs;
  bool fixHit = c.abFixOn && d.warmwasser <= c.abFixT;
  bool relHit = !isnan(diff) && ((c.abOn && diff <= c.abK) || (c.abLow && diff < 0));
  if (fixHit || relHit) {
    abLatch(true);
    if (fixHit) {
      abInfoSet("Puffer bis zur naechsten WW-Ladung (WW %.1f <= %u C)", d.warmwasser, c.abFixT);
      Log.printf("Puffer-Automatik: WW %.1f C <= %u C -> Puffer bis zur naechsten WW-Ladung\n", d.warmwasser, c.abFixT);
    } else {
      abInfoSet("Puffer bis zur naechsten WW-Ladung (WW %.1f, VL-Soll %.0f)", d.warmwasser, vs);
      Log.printf("Puffer-Automatik: WW %.1f C nur noch %+.1f K zum VL-Soll %.0f C -> Puffer bis zur naechsten WW-Ladung\n", d.warmwasser, diff, vs);
    }
    return c.bufPos;
  }
  if (c.abFixOn && (!relOn || isnan(diff))) abInfoSet("Heizung: WW %.1f C, Puffer ab %u C", d.warmwasser, c.abFixT);
  else if (c.abFixOn) abInfoSet("Heizung: WW %.1f C (Puffer ab %u C oder %+.1f K <= %d K)", d.warmwasser, c.abFixT, diff, c.abOn ? (int)c.abK : 0);
  else abInfoSet("Heizung: WW %.1f C, VL-Soll %.0f C (%+.1f K > %d K)", d.warmwasser, vs, diff, c.abOn ? (int)c.abK : 0);
  return 0;
}

static uint32_t lastEventKey = 0xFFFFFFFF;

void scheduleTick() {
  if (!timeValid()) return;
  time_t tt = time(nullptr); struct tm tmv; localtime_r(&tt, &tmv);
  int today = (tmv.tm_wday + 6) % 7;
  int nowMin = tmv.tm_hour * 60 + tmv.tm_min;
  uint32_t key = today * 1440 + nowMin;
  if (key == lastEventKey) return;
  bool first = (lastEventKey == 0xFFFFFFFF);
  lastEventKey = key;
  if (first) return;                                            // beim Start nichts nachholen
  CtrlCfg c = getCtrlCfg();
  for (int s = 0; s < SCHED_SLOTS; s++) {
    const SchedEv& e = c.sched[today][s];
    if (e.act == ACT_NONE || (int)e.min != nowMin) continue;
    Log.printf("Zeitplan %s %02d:%02d: %s\n", WDAY_NAME[today], e.min / 60, e.min % 60, actName(e.act));
    manualPos = -1;                                             // Handbetrieb endet
    if (e.act == ACT_WW) {
      uint32_t k = today * 1440 + e.min;
      if (k == wwPullTryKey) wwPullTryKey = KEY_NONE;
      if (k == wwPulledKey) { wwPulledKey = KEY_NONE; Log.println("WW: Ladung wurde schon vorgezogen -> entfaellt"); continue; }
      reqWwStart = true;
    }
  }
}

void sgTick();                  // MQTT/SG-Teil weiter unten
void hcTick();
void vlTick();
void fcTick();
void pvTick();
void offTick();

void ctrlTask(void*) {
  loadValveState();
  loadWwRun();
  uint32_t settleUntil = millis() + 20000;                      // erst Modbus-Werte abwarten
  for (;;) {
    if ((int32_t)(millis() - settleUntil) > 0) { sgTick(); hcTick(); vlTick(); fcTick(); pvTick(); offTick(); }
    if (!ctrlCfg.enabled) {                                     // Steuerung deaktiviert
      if (vphase != VP_IDLE) {
        relayWrite(ctrlCfg.pinPwr, false); dirRelay(false);
        vphase = VP_IDLE; vQueued = -1; valveMoving = false; valveKnown = false;
        saveValveState(false);
        Log.println("ESBE: Steuerung deaktiviert -> Fahrt abgebrochen");
      }
      if (wwState == WW_MOVE || wwState == WW_HEAT) wwFinish("Steuerung deaktiviert");
      if (wwState == WW_COOL) { wwState = WW_IDLE; saveWwRun(false); }
      if (wwState == WW_BACK) { wwRestorePump(); wwState = WW_IDLE; saveWwRun(false); }
      reqWwStart = false; reqWwStop = false; reqValve = -2;
      if (wwRecover) wwTick();                                  // nur Sollwert-Wiederherstellung
      vTaskDelay(pdMS_TO_TICKS(200));
      continue;
    }
    if (reqValve != -2) {
      int r = reqValve; reqValve = -2;
      manualPos = r;                                            // -1 = Automatik
      Log.printf("ESBE: %s\n", r < 0 ? "Automatik" : "Handbetrieb");
    }
    scheduleTick();
    if ((int32_t)(millis() - settleUntil) > 0) wwPullTick();
    wwTick();
    if (ctrlCfg.wwMode == 1) {                                  // WW-Modus der WP: kein Ventil am ESP
    } else if (ctrlCfg.drive == 1) {                            // Ventilmodul faehrt selbst
      if ((int32_t)(millis() - settleUntil) > 0) {
        CtrlCfg c = getCtrlCfg();
        LiveData d = getLive();
        int want = valveDesired(c, d);
        if (want != slaveTarget) Log.printf("Ventilmodul: Soll %d %%\n", want);
        slaveTarget = want;
        valveTarget = want;
      }
    } else {
      if (reqValveRef) { reqValveRef = false; if (vphase == VP_IDLE) { valveKnown = false; Log.println("ESBE: Referenzfahrt"); } }
      valveTick();
      if (vphase == VP_IDLE && vQueued < 0 && (int32_t)(millis() - settleUntil) > 0) {
        CtrlCfg c = getCtrlCfg();
        LiveData d = getLive();
        int want = valveDesired(c, d);
        if (!valveKnown || fabsf(valvePos - want) >= 2.0f) valveBeginMove(want);
      }
    }
    vTaskDelay(pdMS_TO_TICKS(50));
  }
}

// Kurztext fuer Display-Kopfzeile
void valveShortText(char* out, size_t n) {
  if (!ctrlCfg.enabled || ctrlCfg.wwMode == 1) { out[0] = 0; return; }
  if (ctrlCfg.drive == 0 && (ctrlCfg.pinPwr < 0 || ctrlCfg.pinDir < 0)) { out[0] = 0; return; }
  if (ctrlCfg.drive == 1 && !slaveOnline) { strlcpy(out, "V !MB", n); return; }
  if (valveMoving)      snprintf(out, n, "V%s%.0f%%", valveDirWW ? ">" : "<", valvePosNow());
  else if (!valveKnown) strlcpy(out, "V ?", n);
  else if (valvePos <= 1)  strlcpy(out, "V HZ", n);
  else if (valvePos >= 99) strlcpy(out, "V WW", n);
  else snprintf(out, n, "V %.0f%%", valvePos);
}

// =====================================================
// MQTT (Venus OS), SG-Ready, PV-Warmwasser, Heizstab, VL per MQTT
// =====================================================
//
//  Status:   <base>/state    JSON, retained, alle <interval> s
//            <base>/status   "online" / "offline" (Last Will)
//  Befehle:  <base>/cmd/vl      Zahl     Heiz-VL-Sollwert (ratenbegrenzt)
//            <base>/cmd/sg      1..4     SG-Ready (muss regelmaessig wiederholt werden)
//            <base>/cmd/wwload  0 / 1 / Zahl   WW-Ladung stoppen / starten / mit Ziel-Temp starten
//            <base>/cmd/power   0 / 1    WP aus / ein
//            <base>/cmd/mode    heizen / ww / kuehlen
//            <base>/cmd/valve   heizung / puffer / ww / auto
//            <base>/cmd/heater  0 / Minuten   Heizstab von Hand (z. B. 60 = 60 min)
//            <base>/cmd/console Text     beliebiger Konsolen-Befehl (wie im Web)

MqttCfg mqttCfg;
PvCfg   pvCfg;
esp_mqtt_client_handle_t mqttClient = nullptr;
volatile bool     mqttConnected = false;
volatile uint32_t mqttRxCount = 0, mqttTxCount = 0;
char mqttLastCmd[64] = "";

// (keine Templates: der Arduino-Vorverarbeiter erzeugt dafuer fehlerhafte Prototypen)
bool loadBlobRaw(const char* ns, void* v, size_t sz, uint8_t version) {
  Preferences p;
  p.begin(ns, true);
  size_t have = p.getBytesLength("cfg");
  uint8_t buf[256];
  bool ok = have > 0 && have <= sz && sz <= sizeof(buf);     // kuerzer = aeltere Version, neue Felder bleiben Standard
  if (ok) ok = p.getBytes("cfg", buf, have) == have && buf[0] == version;
  p.end();
  if (ok) memcpy(v, buf, have);
  return ok;
}
void saveBlobRaw(const char* ns, const void* v, size_t sz) {
  Preferences p;
  p.begin(ns, false);
  p.putBytes("cfg", v, sz);
  p.end();
}
void loadMqttCfg() { loadBlobRaw("mqtt", &mqttCfg, sizeof(mqttCfg), MqttCfg().version); }
void saveMqttCfg() { saveBlobRaw("mqtt", &mqttCfg, sizeof(mqttCfg)); }
void loadPvCfg() {
  loadBlobRaw("pv", &pvCfg, sizeof(pvCfg), PvCfg().version);
  Preferences p; p.begin("pv", true);
  gridPhases = p.getUChar("phases", 3);
  pElFactor = p.getUShort("pfac", 100);
  elSrc = p.getUChar("elsrc", 0);
  if (p.getBytesLength("eltopic") == sizeof(elTopic)) p.getBytes("eltopic", elTopic, sizeof(elTopic));
  elTopic[sizeof(elTopic) - 1] = 0;
  p.end();
}
void savePvCfg() {
  saveBlobRaw("pv", &pvCfg, sizeof(pvCfg));
  Preferences p; p.begin("pv", false);
  p.putUChar("phases", gridPhases);
  p.putUShort("pfac", pElFactor);
  p.putUChar("elsrc", elSrc);
  p.putBytes("eltopic", elTopic, sizeof(elTopic));
  p.end();
}

// ---------- SG-Ready ----------
volatile uint32_t sgLastMs = 0;
static bool  sgBlocked = false, sgSavedOn = false;

const char* sgName(int s) {
  switch (s) {
    case 1: return "SG1 Sperre";
    case 2: return "SG2 normal";
    case 3: return "SG3 PV";
    case 4: return "SG4 PV max";
    default: return "?";
  }
}

void sgSet(int s, const char* src) {
  if (s < 1 || s > 4) return;
  if (!pvCfg.show) return;                       // PV/Energiemanagement ausgeschaltet -> SG-Ready ignorieren
  sgLastMs = millis();
  if (s != sgState) Log.printf("SG-Ready: %s -> %s (%s)\n", sgName(sgState), sgName(s), src);
  sgState = s;
}

// laeuft im ctrl-Task
void sgTick() {
  PvCfg p = pvCfg;
  LiveData d = getLive();
  if (!p.show && sgState != 2) sgState = 2;
  if (sgState != 2 && p.sgTimeoutMin > 0 && millis() - sgLastMs > p.sgTimeoutMin * 60000UL) {
    Log.printf("SG-Ready: %u min keine Auffrischung -> SG2\n", p.sgTimeoutMin);
    sgState = 2;
  }

  // SG1: WP sperren (max. so lange, wie SG1 aufgefrischt wird)
  if (sgState == 1 && p.sg1Block && !sgBlocked && d.wpStateValid) {
    sgBlocked = true;
    sgSavedOn = d.wpOnOffRaw;
    if (d.wpOnOffRaw) powerCmd(false, "SG1-Sperre");
  }
  if (sgState != 1 && sgBlocked) {
    sgBlocked = false;
    if (sgSavedOn) powerCmd(true, "SG1 beendet");
  }

  // SG3/4: Warmwasser mit PV-Ueberschuss per WP laden
  bool pv = (sgState == 3 || sgState == 4);
  CtrlCfg c = getCtrlCfg();
  if (pv && p.pvWwEnable && c.enabled && wwState == WW_IDLE && !reqWwStart && d.tempsValid &&
      d.warmwasser < p.pvWwSoll - p.pvWwHyst) {
    reqWwTarget = p.pvWwSoll;
    reqWwPv = true;
    reqWwStart = true;
  }
  // PV vorbei -> PV-Ladung abbrechen
  if (!pv && pvLoad && (wwState == WW_MOVE || wwState == WW_HEAT)) {
    Log.println("SG: kein PV-Ueberschuss mehr -> PV-Ladung beenden");
    reqWwStop = true;
  }
}

// ---------- Heizstab (Shelly) ----------
volatile bool     heaterOn = false;          // zuletzt erfolgreich gesetzter Zustand
volatile uint32_t heaterManualUntil = 0;     // millis()-Zeitpunkt, 0 = kein Handbetrieb
static uint32_t   heaterOnSince = 0;
static bool       heaterLockout = false;     // Max-Laufzeit erreicht, bis SG wechselt
char heaterInfo[48] = "aus";

bool shellySwitch(bool on) {
  PvCfg p = pvCfg;
  if (!p.shellyIp[0] || WiFi.status() != WL_CONNECTED) return false;
  char url[160];
  // Selbstabschaltung nach 180 s, falls der ESP haengt -> wird alle 60 s erneuert
  if (p.heaterGen == 1)
    snprintf(url, sizeof(url), "http://%s/relay/0?turn=%s%s", p.shellyIp, on ? "on" : "off", on ? "&timer=180" : "");
  else
    snprintf(url, sizeof(url), "http://%s/rpc/Switch.Set?id=0&on=%s%s", p.shellyIp, on ? "true" : "false",
             on ? "&toggle_after=180" : "");
  HTTPClient http;
  http.setConnectTimeout(2000);
  http.setTimeout(2500);
  bool ok = false;
  if (http.begin(url)) {
    int code = http.GET();
    ok = (code == 200);
    if (!ok) Log.printf("Heizstab: Shelly antwortet %d\n", code);
    http.end();
  }
  return ok;
}
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
