waju84/Avarma-R290-Steuerung/(commit log)

2026-11-10 ESP32-S3-Fassung v1.36
2026-11-10 Node-RED-Flows (optional)
2026-11-10 Bilder der Oberfläche
